jakubprzybytek/Environmental-Sensors/STM32CubeIDE/EnvSensorV2/ReadMe.md

## ToDo

### Software
* Logging data to SD card
* Displaying data from SD card using graphs
* Display
    - use it/dma mode to talk with display
* Get rid of synchronisation over I2C
    - Fix synchronisation issue
* Particles sensor
    - fix issue with auto start failure
    - stopAutoSend really needed?
    - calibration?

### Hardware
* Fix dc converters squeak
* Enable super capacitor as battery supply for RTC
* Run RTC on cristal
