jakubprzybytek/Environmental-Sensors/STM32CubeIDE/EnvSensorV2.1/TouchGFX/assets/images/low-batt-250.png

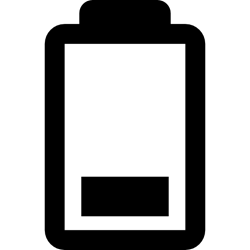
STM32CubeIDE/EnvSensorV2.1/TouchGFX/assets/images/low-batt-250.png
