jakubprzybytek/Environmental-Sensors/3dPrints/SFSD-05-28-H-05.00-SR.stp

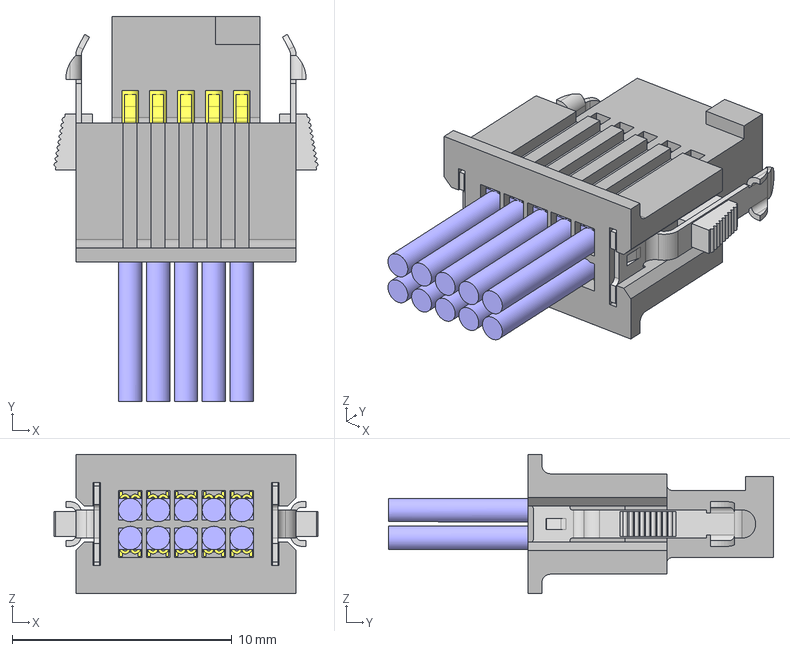
[picture p2: CAD file, 2024-03-20]
3dPrints/SFSD-05-28-H-05.00-SR.stp
12.0 x 17.5 x 6.35 mm
SFSD-05-28-SR_b
SFSD-05-28-D-NUS_ca
SFSX-RL x 2
SFSD-05_p x 2
