jakubprzybytek/Environmental-Sensors/KiCad/EnvSensor-Main-v2.1/Body1.stl

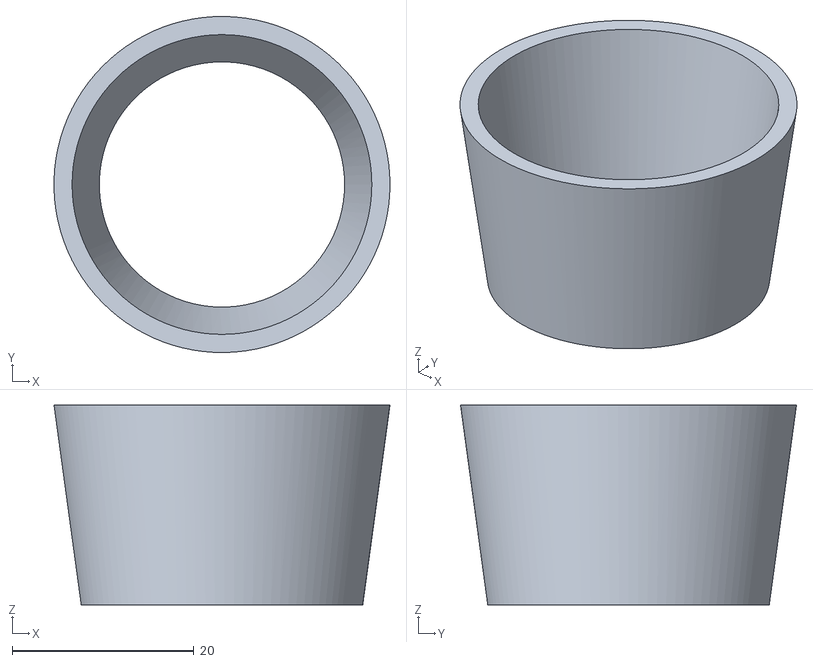
[picture p3: CAD file, 2024-09-21]
KiCad/EnvSensor-Main-v2.1/Body1.stl
37.0 x 37.0 x 22.0
