jakubprzybytek/Environmental-Sensors/3dPrints/Buttons Membrane v1.stl

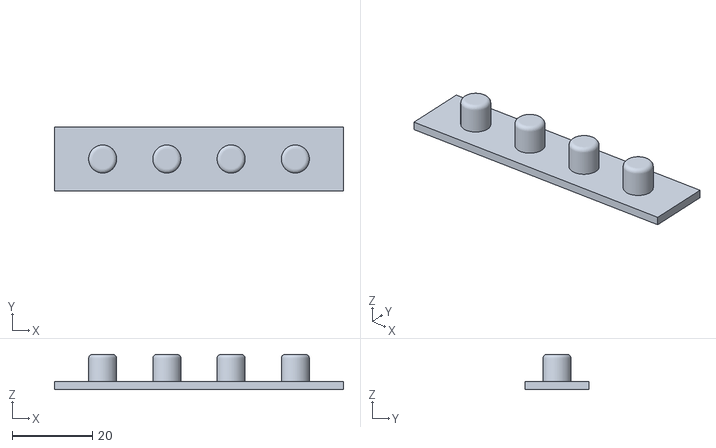
[picture p4: CAD file, 2021-03-12]
3dPrints/Buttons Membrane v1.stl
72.0 x 16.0 x 8.80
