jakubprzybytek/Environmental-Sensors/3dPrints/Case Bottom v2.stl

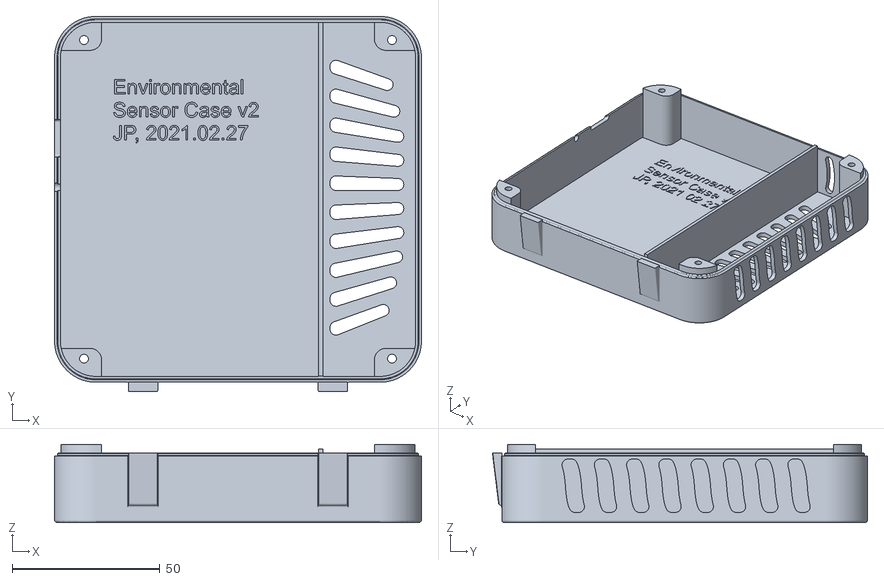
[picture p5: CAD file, 2021-03-12]
3dPrints/Case Bottom v2.stl
124.4 x 127.2 x 26.6
