jakubprzybytek/Environmental-Sensors/3dPrints/Case Top v2.stl

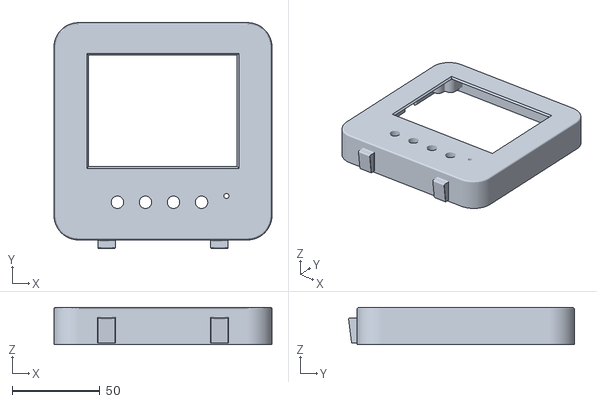
[picture p6: CAD file, 2021-03-12]
3dPrints/Case Top v2.stl
124.4 x 128.8 x 21.2
