jakubprzybytek/Environmental-Sensors/(list of files, cad)

Other CAD files:
3dPrints/Environmental Sensor Case v6.f3d
