jakubprzybytek/Environmental-Sensors/KiCad/EnvSensor-Power-v2.1/EnvSensor-Power-v2.1.kicad_pcb

## KiCad design KiCad/EnvSensor-Power-v2.1/EnvSensor-Power-v2.1.kicad_pcb (2024-12-12)

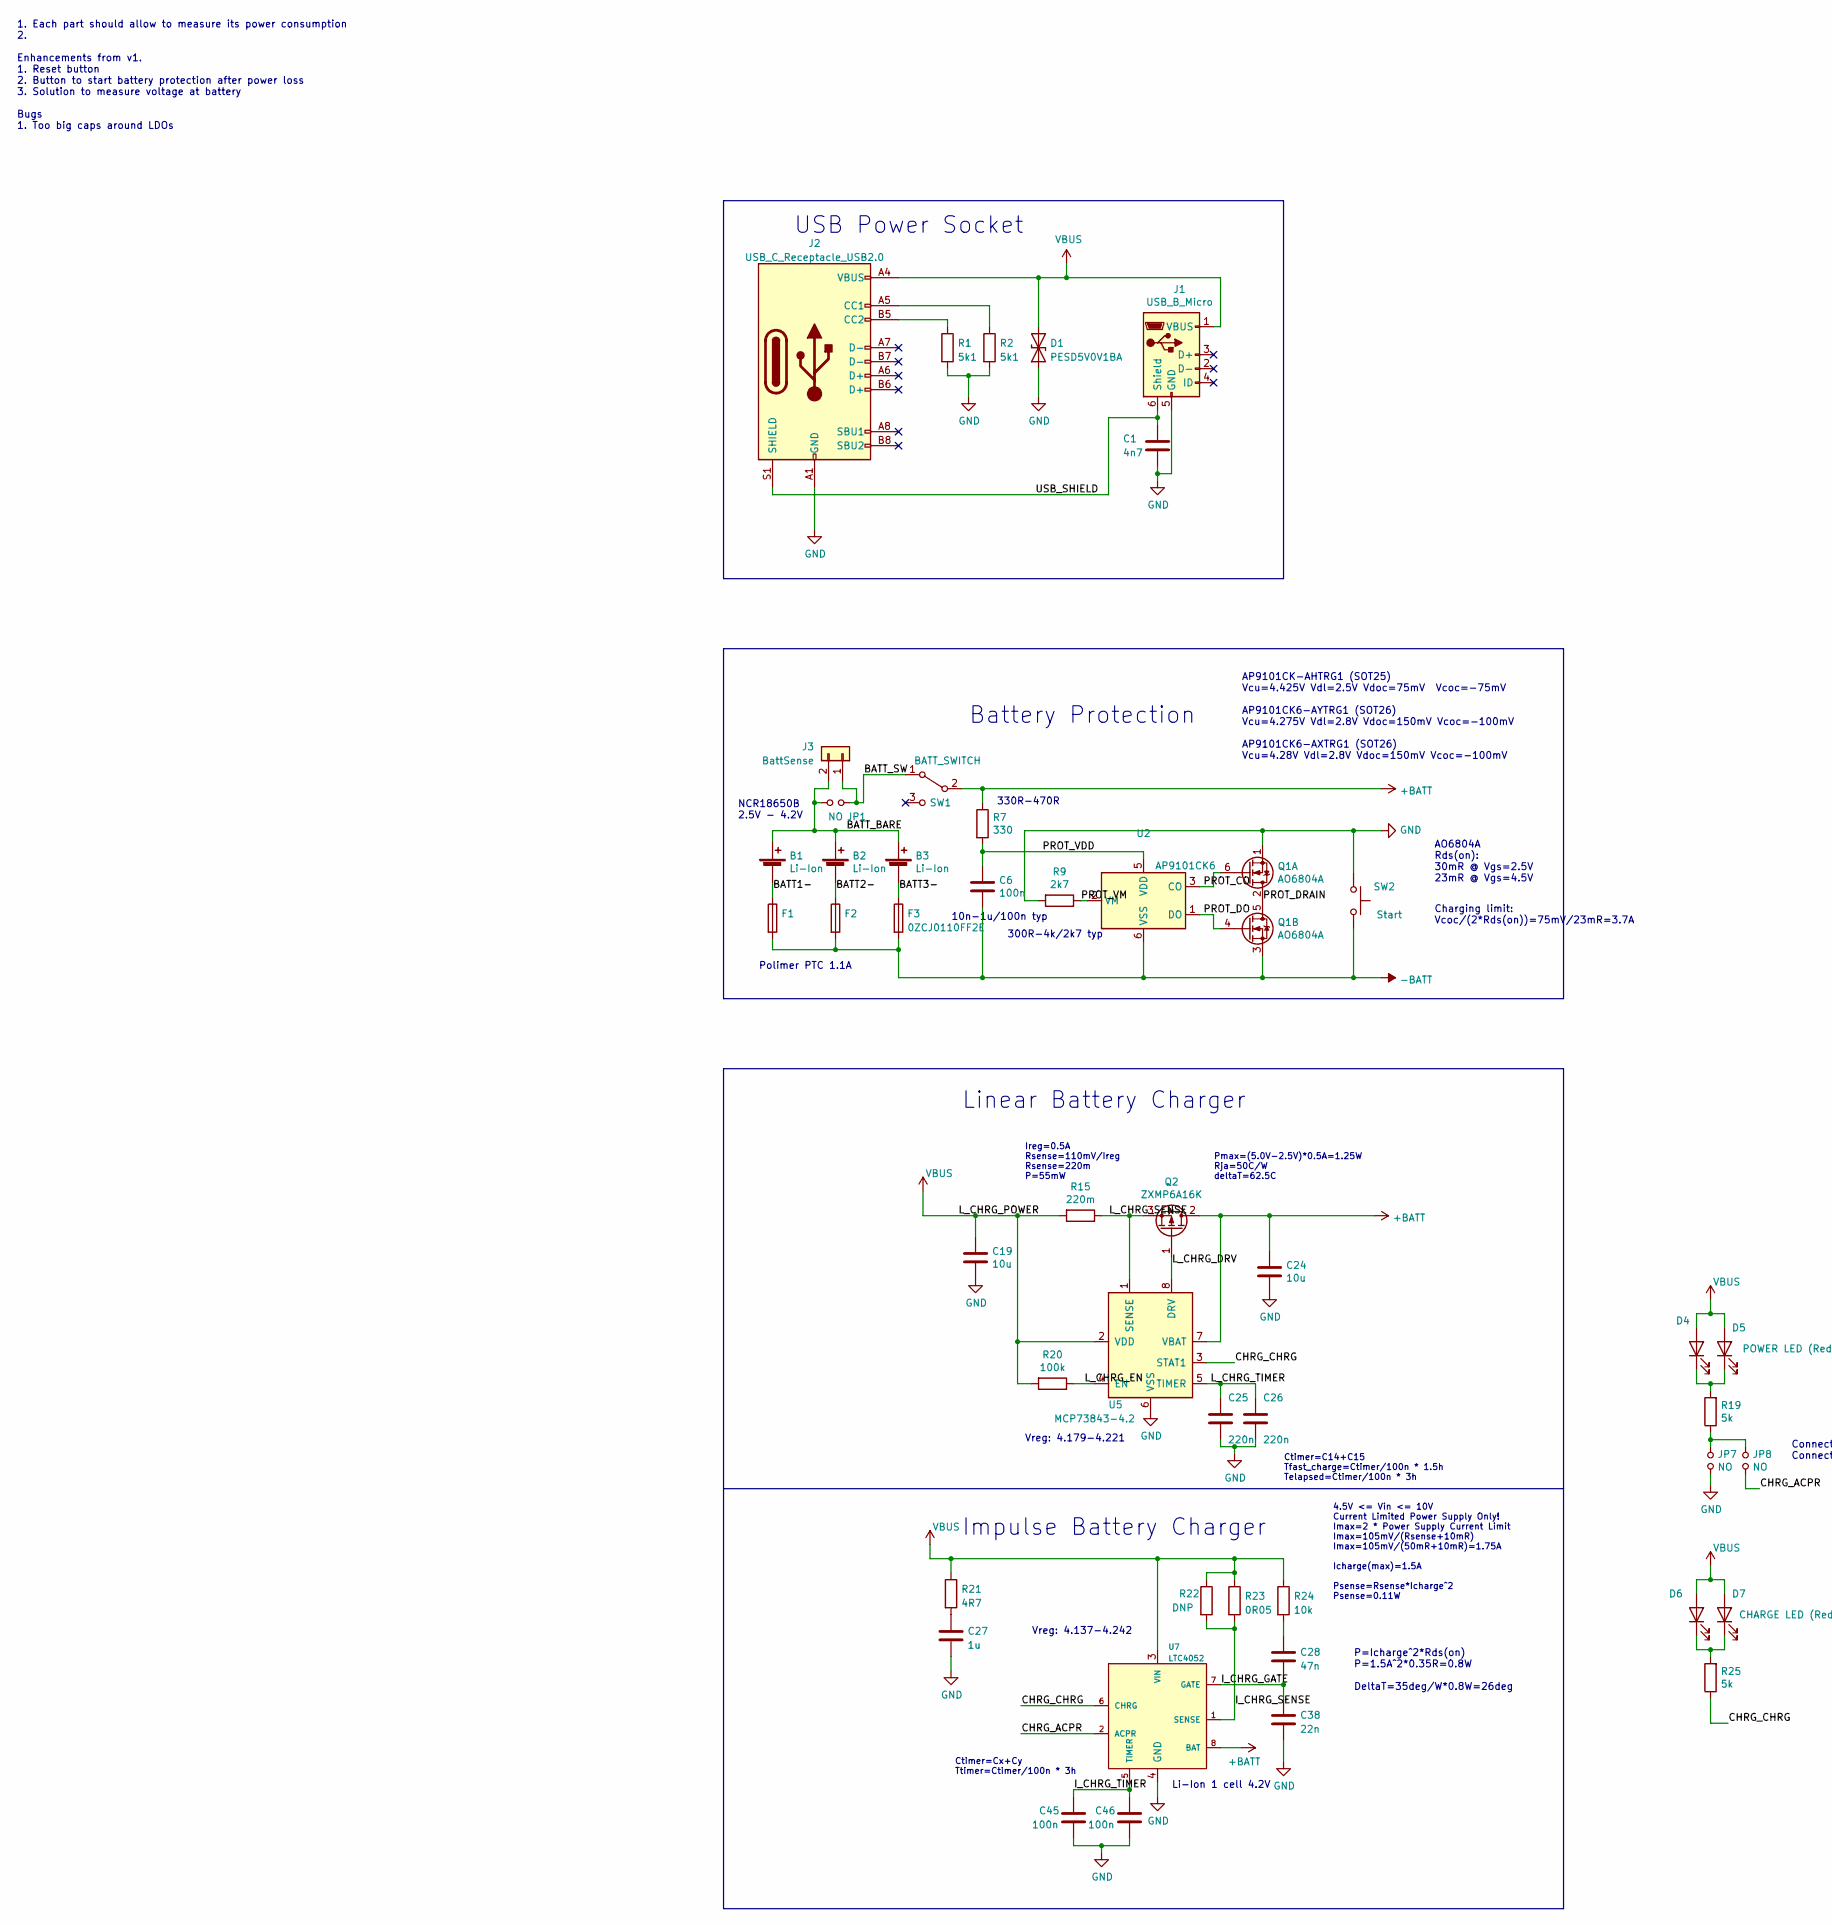
[picture p7: schematic EnvSensor-Power-v2.1.kicad_sch, Environmental Sensor Power Supply, part in row 1, column 1]

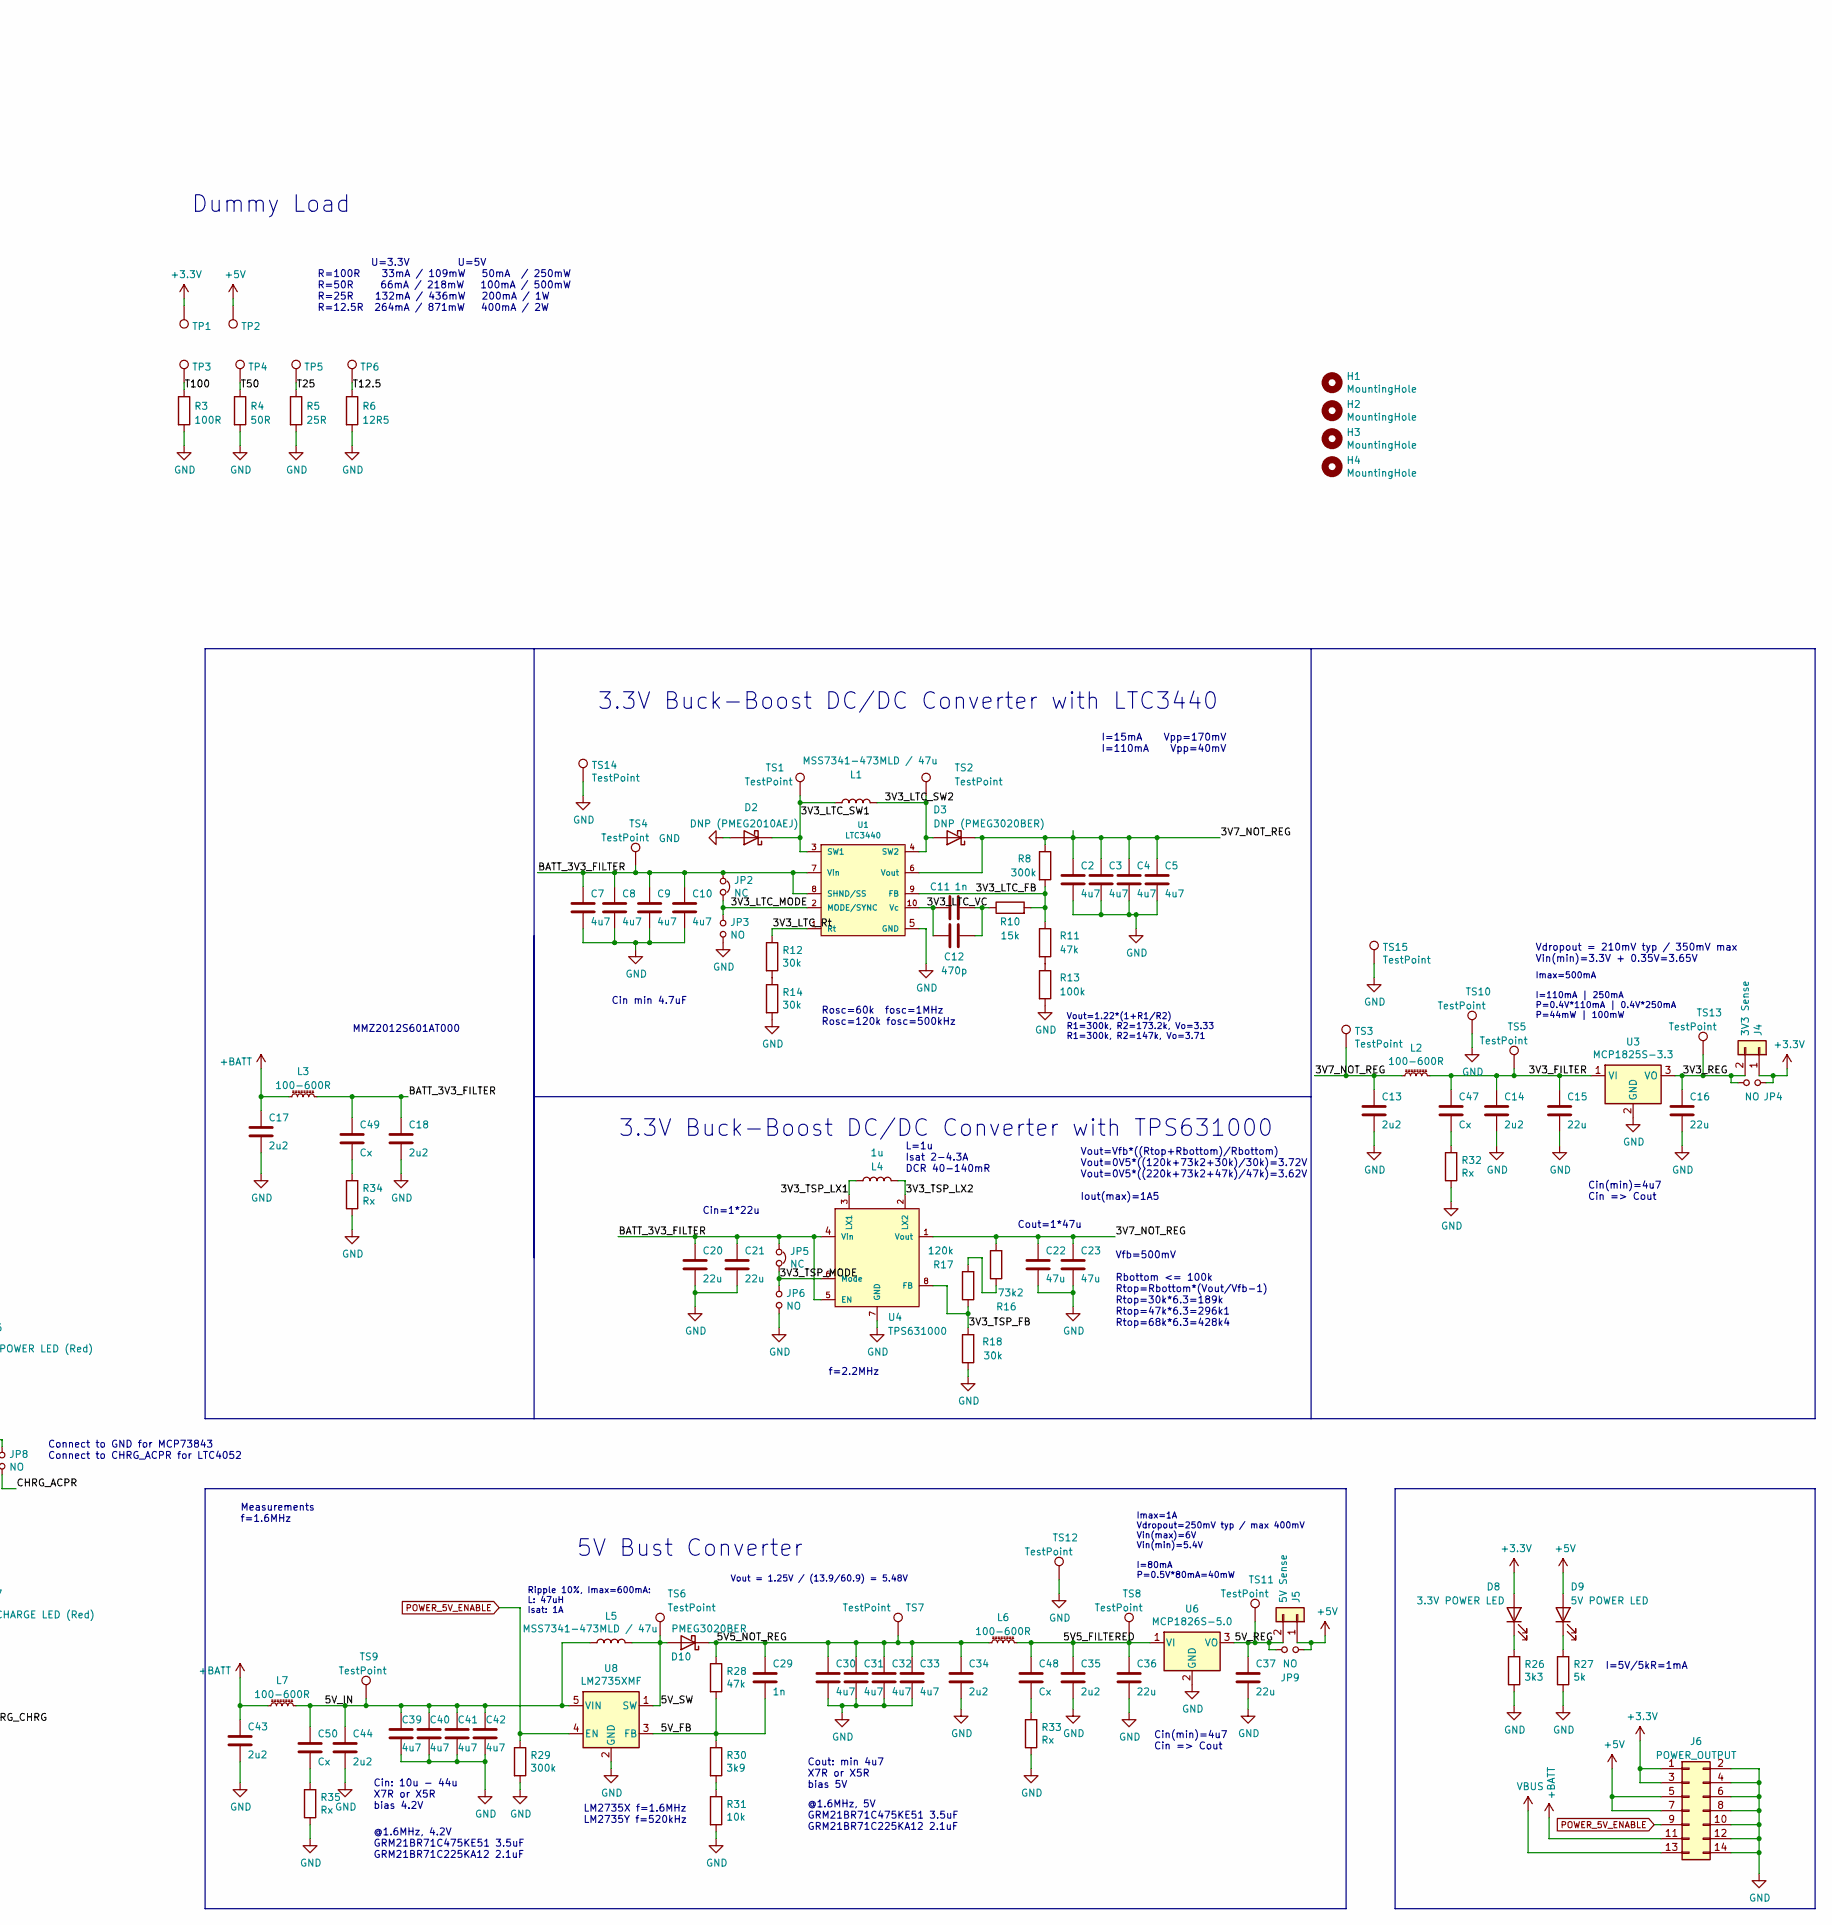
[picture p8: schematic EnvSensor-Power-v2.1.kicad_sch, Environmental Sensor Power Supply, part in row 1, column 2]

Parts:
B1, B2, B3: Li-Ion; BatteryHolder_Keystone_1042_1x18650
C1: 4n7; C_0805_2012Metric
C2, C3, C4, C5, C7, C8, C9, C10, C30, C31, C32, C33, C39, C40, C41, C42: 4u7; C_0805_2012Metric
C6, C45, C46: 100n; C_0603_1608Metric
C11, C29: 1n; C_0805_2012Metric
C12: 470p; C_0805_2012Metric
C13, C14, C17, C18, C34, C35, C43, C44: 2u2; C_0805_2012Metric
C15, C16, C20, C21, C36, C37: 22u; C_1206_3216Metric
C19, C24: 10u; C_0805_2012Metric
C22, C23: 47u; C_1206_3216Metric
C25, C26: 220n; C_0805_2012Metric
C27: 1u; C_0805_2012Metric
C28: 47n; C_0805_2012Metric
C38: 22n; C_0805_2012Metric
C47, C48, C49, C50: Cx; C_0805_2012Metric
D1: PESD5V0V1BA; D_SOD-323_HandSoldering
D2: DNP (PMEG2010AEJ); D_SOD-323_HandSoldering
D3: DNP (PMEG3020BER); D_SOD-123
D4: POWER LED (Red); LED_0805_2012Metric
D5: POWER LED (Red); LED_D3.0mm_Horizontal_O3.81mm_Z6.0mm
D6: CHARGE LED (Red); LED_0805_2012Metric
D7: CHARGE LED (Red); LED_D3.0mm_Horizontal_O3.81mm_Z6.0mm
D8: 3.3V POWER LED; LED_0805_2012Metric
D9: 5V POWER LED; LED_0805_2012Metric
D10: PMEG3020BER; D_SOD-123
F1, F2, F3: 0ZCJ0110FF2E; Fuse_1206_3216Metric
H1, H2, H3, H4: MountingHole; MountingHole_3.2mm_M3
J1: USB_B_Micro; USB_Micro-B_Molex_47346-0001
J2: USB_C_Receptacle_USB2.0; USB_C_Receptacle_GCT_USB4135-GF-A_6P_TopMnt_Horizontal
J3: BattSense; PinHeader_1x02_P2.54mm_Horizontal
J4: 3V3 Sense; PinHeader_1x02_P2.54mm_Horizontal
J5: 5V Sense; PinHeader_1x02_P2.54mm_Horizontal
J6: POWER_OUTPUT; PinHeader_2x07_P2.54mm_Vertical
JP1, JP3, JP4, JP6, JP7, JP8, JP9: NO; SolderJumper-2_P1.3mm_Open_RoundedPad1.0x1.5mm
JP2, JP5: NC; SolderJumper-2_P1.3mm_Bridged_RoundedPad1.0x1.5mm
L1, L5: MSS7341-473MLD / 47u; L_Bourns-SRN8040_8x8.15mm
L2, L3, L6, L7: 100-600R; L_0805_2012Metric
L4: 1u; L_0805_2012Metric
Q1: AO6804A; TSOT-23-6
Q2: ZXMP6A16K; TO-252-2
R1, R2: 5k1; R_0805_2012Metric
R3: 100R; R_2512_6332Metric
R4: 50R; R_2512_6332Metric
R5: 25R; R_2512_6332Metric
R6: 12R5; R_2512_6332Metric
R7: 330; R_0805_2012Metric
R8, R29: 300k; R_0805_2012Metric
R9: 2k7; R_0805_2012Metric
R10: 15k; R_0805_2012Metric
R11, R28: 47k; R_0805_2012Metric
R12, R14, R18: 30k; R_0805_2012Metric
R13: 100k; R_0805_2012Metric
R15: 220m; R_1206_3216Metric
R16: 73k2; R_0805_2012Metric
R17: 120k; R_0805_2012Metric
R19, R25, R27: 5k; R_0805_2012Metric
R20: 100k; R_0603_1608Metric
R21: 4R7; R_0805_2012Metric
R22: DNP; R_1206_3216Metric
R23: 0R05; R_1206_3216Metric
R24: 10k; R_0603_1608Metric
R26: 3k3; R_0805_2012Metric
R30: 3k9; R_0805_2012Metric
R31: 10k; R_0805_2012Metric
R32, R33, R34, R35: Rx; R_0805_2012Metric
SW1: BATT_SWITCH; SW_Lever_1P2T_NKK_GW12LxH
SW2: Start; SW_SPST_CK_RS282G05A3
TP1, TP2, TP3, TP4, TP5, TP6: TestPoint; TestPoint_THTPad_D1.5mm_Drill0.7mm
TS1, TS2, TS3, TS4, TS5, TS6, TS7, TS8, TS9, TS10, TS11, TS12, TS13, TS14, TS15: TestPoint; TestPoint_THTPad_D1.5mm_Drill0.7mm
U1: LTC3440; MSOP-10_3x3mm_P0.5mm
U2: AP9101CK6; SOT-23-6
U3: MCP1825S-3.3; SOT-223-3_TabPin2
U4: TPS631000; SOT-5x3
U5: MCP73843-4.2; MSOP-8_3x3mm_P0.65mm
U6: MCP1826S-5.0; SOT-223-3_TabPin2
U7: LTC4052; MSOP-8_3x3mm_P0.65mm
U8: LM2735XMF; SOT-23-5

Connections:
+3V3: D8.2 (A), J4.1, J6.1, J6.3, JP4.2, TP1.1
+5V: D9.2 (A), J5.1, J6.5, J6.7, JP9.2, TP2.1
+BATT: C17.1, C24.1, C43.1, J6.11, L3.1, L7.1, Q2.2 (D), R7.1, SW1.2 (B), U5.7 (VBAT), U7.8 (BAT)
-BATT: C6.2, F1.2, F2.2, F3.2, Q1.3 (S2), SW2.1, U2.6 (VSS)
/3V3_FILTER: C14.1, C15.1, C47.1, L2.2, TS5.1, U3.1 (VI)
/3V3_LTC_FB: R8.2, R10.2, R11.1, U1.9 (FB)
/3V3_LTC_MODE: JP2.2, JP3.1, U1.2 (MODE/SYNC)
/3V3_LTC_Rt: R12.1, U1.1 (Rt)
/3V3_LTC_SW1: D2.1 (K), L1.1, TS1.1, U1.3 (SW1)
/3V3_LTC_SW2: D3.2 (A), L1.2, TS2.1, U1.4 (SW2)
/3V3_LTC_VC: C11.2, C12.2, U1.10 (Vc)
/3V3_REG: C16.1, J4.2, JP4.1, TS13.1, U3.3 (VO)
/3V3_TSP_FB: R17.1, R18.2, U4.8 (FB)
/3V3_TSP_LX1: L4.1, U4.3 (LX1)
/3V3_TSP_LX2: L4.2, U4.2 (LX2)
/3V3_TSP_MODE: JP5.2, JP6.1, U4.6 (Mode)
/3V7_NOT_REG: C2.1, C3.1, C4.1, C5.1, C13.1, C22.1, C23.1, D3.1 (K), L2.1, R8.1, R16.2, TS3.1, U1.6 (Vout), U4.1 (Vout)
/5V5_FILTERED: C35.1, C36.1, C48.1, L6.2, TS8.1, U6.1 (VI)
/5V5_NOT_REG: C29.1, C30.1, C31.1, C32.1, C33.1, C34.1, D10.1 (K), L6.1, R28.1, TS7.1
/5V_FB: C29.2, R28.2, R30.1, U8.3 (FB)
/5V_IN: C39.1, C40.1, C41.1, C42.1, C44.1, C50.1, L5.1, L7.2, TS9.1, U8.5 (VIN); also elsewhere on the board
/5V_REG: C37.1, J5.2, JP9.1, TS11.1, U6.3 (VO)
/5V_SW: D10.2 (A), L5.2, TS6.1, U8.1 (SW)
/BATT1-: B1.2 (-), F1.1
/BATT2-: B2.2 (-), F2.1
/BATT3-: B3.2 (-), F3.1
/BATT_3V3_FILTER: C7.1, C8.1, C9.1, C10.1, C18.1, C20.1, C21.1, C49.1, JP2.1, JP5.1, L3.2, TS4.1, U1.7 (Vin), U1.8 (SHND/SS), U4.4 (Vin), U4.5 (EN)
/BATT_BARE: B1.1 (+), B2.1 (+), B3.1 (+), J3.2, JP1.1
/BATT_SW: J3.1, JP1.2, SW1.1 (A)
/CHRG_ACPR: JP8.2, U7.2 (ACPR)
/CHRG_CHRG: R25.1, U5.3 (STAT1), U7.6 (CHRG)
/I_CHRG_GATE: C28.2, C38.1, U7.7 (GATE)
/I_CHRG_SENSE: R22.2, R23.2, U7.1 (SENSE)
/I_CHRG_TIMER: C45.1, C46.1, U7.5 (TIMER)
/L_CHRG_DRV: Q2.1 (G), U5.8 (DRV)
/L_CHRG_EN: R20.1, U5.4 (EN)
/L_CHRG_SENSE: Q2.3 (S), R15.1, U5.1 (SENSE)
/L_CHRG_TIMER: C25.1, C26.1, U5.5 (TIMER)
/PROT_CO: Q1.6 (G2), U2.3 (CO)
/PROT_DO: Q1.4 (G2), U2.1 (DO)
/PROT_DRAIN: Q1.2 (D2), Q1.5 (D2)
/PROT_VDD: C6.1, R7.2, U2.5 (VDD)
/PROT_VM: R9.1, U2.2 (VM)
/T12.5: R6.1, TP6.1
/T25: R5.1, TP5.1
/T50: R4.1, TP4.1
/T100: R3.1, TP3.1
/USB_SHIELD: C1.1, J1.6 (Shield), J2.S1 (SHIELD)
GND: C1.2, C2.2, C3.2, C4.2, C5.2, C7.2, C8.2, C9.2, C10.2, C13.2, C14.2, C15.2, C16.2, C17.2, C18.2, C19.2, C20.2, C21.2, C22.2, C23.2, C24.2, C25.2, C26.2, C27.2, C30.2, C31.2, C32.2, C33.2, C34.2, C35.2, C36.2, C37.2, C38.2, C39.2, C40.2, C41.2, C42.2, C43.2, C44.2, C45.2, C46.2, D1.1 (A1), D2.2 (A), J1.5 (GND), J2.A1 (GND), J2.A12 (GND), J2.B1 (GND), J2.B12 (GND), J6.2, J6.4, J6.6, J6.8, J6.10, J6.12, J6.14, JP3.2, JP6.2, JP7.2, Q1.1 (S2), R1.2, R2.2, R3.2, R4.2, R5.2, R6.2, R9.2, R13.2, R14.2, R18.1, R26.1, R27.1, R29.2, R31.2, R32.1, R33.1, R34.1, R35.1, SW2.2, TS10.1, TS12.1, TS14.1, TS15.1, U1.5 (GND), U3.2 (GND), U4.7 (GND), U5.6 (VSS), U6.2 (GND), U7.4 (GND), U8.2 (GND)
unnamed: C11.1, C12.1, R10.1
unnamed: C27.1, R21.2
unnamed: C28.1, R24.2
unnamed: C47.2, R32.2
unnamed: C48.2, R33.2
unnamed: C49.2, R34.2
unnamed: C50.2, R35.2
unnamed: D4.1 (K), D5.1 (K), R19.2
unnamed: D6.1 (K), D7.1 (K), R25.2
unnamed: D8.1 (K), R26.2
unnamed: D9.1 (K), R27.2
unnamed: J2.A5 (CC1), R2.1
unnamed: J2.B5 (CC2), R1.1
unnamed: JP7.1, JP8.1, R19.1
unnamed: R11.2, R13.1
unnamed: R12.2, R14.1
unnamed: R16.1, R17.2
unnamed: R30.2, R31.1
POWER_5V_ENABLE: J6.9, R29.1, U8.4 (EN)
VBUS: C19.1, D1.2 (A2), D4.2 (A), D5.2 (A), D6.2 (A), D7.2 (A), J1.1 (VBUS), J2.A4 (VBUS), J2.A9 (VBUS), J2.B4 (VBUS), J2.B9 (VBUS), J6.13, R15.2, R20.2, R21.1, R22.1, R23.1, R24.1, U5.2 (VDD), U7.3 (VIN)

Notes on the sheet:
Ripple 10%, Imax=600mA: L: 47uH Isat: 1A
AP9101CK-AHTRG1 (SOT25) Vcu=4.425V Vdl=2.5V Vdoc=75mV Vcoc=-75mV AP9101CK6-AYTRG1 (SOT26) Vcu=4.275V Vdl=2.8V Vdoc=150mV Vcoc=-100mV AP9101CK6-AXTRG1 (SOT26) Vcu=4.28V Vdl=2.8V Vdoc=150mV Vcoc=-100mV
Cout: min 4u7 X7R or X5R bias 5V
1. Each part should allow to measure its power consumption 2. Enhancements from v1. 1. Reset button 2. Button to start battery protection after power loss 3. Solution to measure voltage at battery Bugs 1. Too big caps around LDOs
Linear Battery Charger
Connect to GND for MCP73843 Connect to CHRG_ACPR for LTC4052
330R-470R
5V Bust Converter
Ireg=0.5A Rsense=110mV/Ireg Rsense=220m P=55mW
MMZ2012S601AT000
Pmax=(5.0V-2.5V)*0.5A=1.25W Rja=50C/W deltaT=62.5C
Ctimer=Cx+Cy Ttimer=Ctimer/100n * 3h
Vfb=500mV Rbottom <= 100k Rtop=Rbottom*(Vout/Vfb-1) Rtop=30k*6.3=189k Rtop=47k*6.3=296k1 Rtop=68k*6.3=428k4
I=15mA Vpp=170mV I=110mA Vpp=40mV
Li-Ion 1 cell 4.2V
3.3V Buck-Boost DC/DC Converter with LTC3440
Impulse Battery Charger
Cin(min)=4u7 Cin => Cout
Cin min 4.7uF
Imax=500mA I=110mA | 250mA P=0.4V*110mA | 0.4V*250mA P=44mW | 100mW
I=5V/5kR=1mA
Cout=1*47u
@1.6MHz, 4.2V GRM21BR71C475KE51 3.5uF GRM21BR71C225KA12 2.1uF
AO6804A Rds(on): 30mR @ Vgs=2.5V 23mR @ Vgs=4.5V
USB Power Socket
4.5V <= Vin <= 10V Current Limited Power Supply Only! Imax=2 * Power Supply Current Limit Imax=105mV/(Rsense+10mR) Imax=105mV/(50mR+10mR)=1.75A Icharge(max)=1.5A Psense=Rsense*Icharge^2 Psense=0.11W
Rosc=60k fosc=1MHz Rosc=120k fosc=500kHz
Cin=1*22u
Ctimer=C14+C15 Tfast_charge=Ctimer/100n * 1.5h Telapsed=Ctimer/100n * 3h
Dummy Load
L=1u Isat 2-4.3A DCR 40-140mR
3.3V Buck-Boost DC/DC Converter with TPS631000
f=2.2MHz
Vreg: 4.179-4.221
Vdropout = 210mV typ / 350mV max Vin(min)=3.3V + 0.35V=3.65V
Cin: 10u - 44u X7R or X5R bias 4.2V
Vout=1.22*(1+R1/R2) R1=300k, R2=173.2k, Vo=3.33 R1=300k, R2=147k, Vo=3.71
P=Icharge^2*Rds(on) P=1.5A^2*0.35R=0.8W DeltaT=35deg/W*0.8W=26deg
U=3.3V U=5V R=100R 33mA / 109mW 50mA / 250mW R=50R 66mA / 218mW 100mA / 500mW R=25R 132mA / 436mW 200mA / 1W R=12.5R 264mA / 871mW 400mA / 2W
Imax=1A Vdropout=250mV typ / max 400mV Vin(max)=6V Vin(min)=5.4V I=80mA P=0.5V*80mA=40mW
300R-4k/2k7 typ
Vout=Vfb*((Rtop+Rbottom)/Rbottom) Vout=0V5*((120k+73k2+30k)/30k)=3.72V Vout=0V5*((220k+73k2+47k)/47k)=3.62V Iout(max)=1A5
Polimer PTC 1.1A
Charging limit: Vcoc/(2*Rds(on))=75mV/23mR=3.7A
@1.6MHz, 5V GRM21BR71C475KE51 3.5uF GRM21BR71C225KA12 2.1uF
LM2735X f=1.6MHz LM2735Y f=520kHz
Vout = 1.25V / (13.9/60.9) = 5.48V
Vreg: 4.137-4.242
NCR18650B 2.5V - 4.2V
Battery Protection
10n-1u/100n typ
Measurements f=1.6MHz

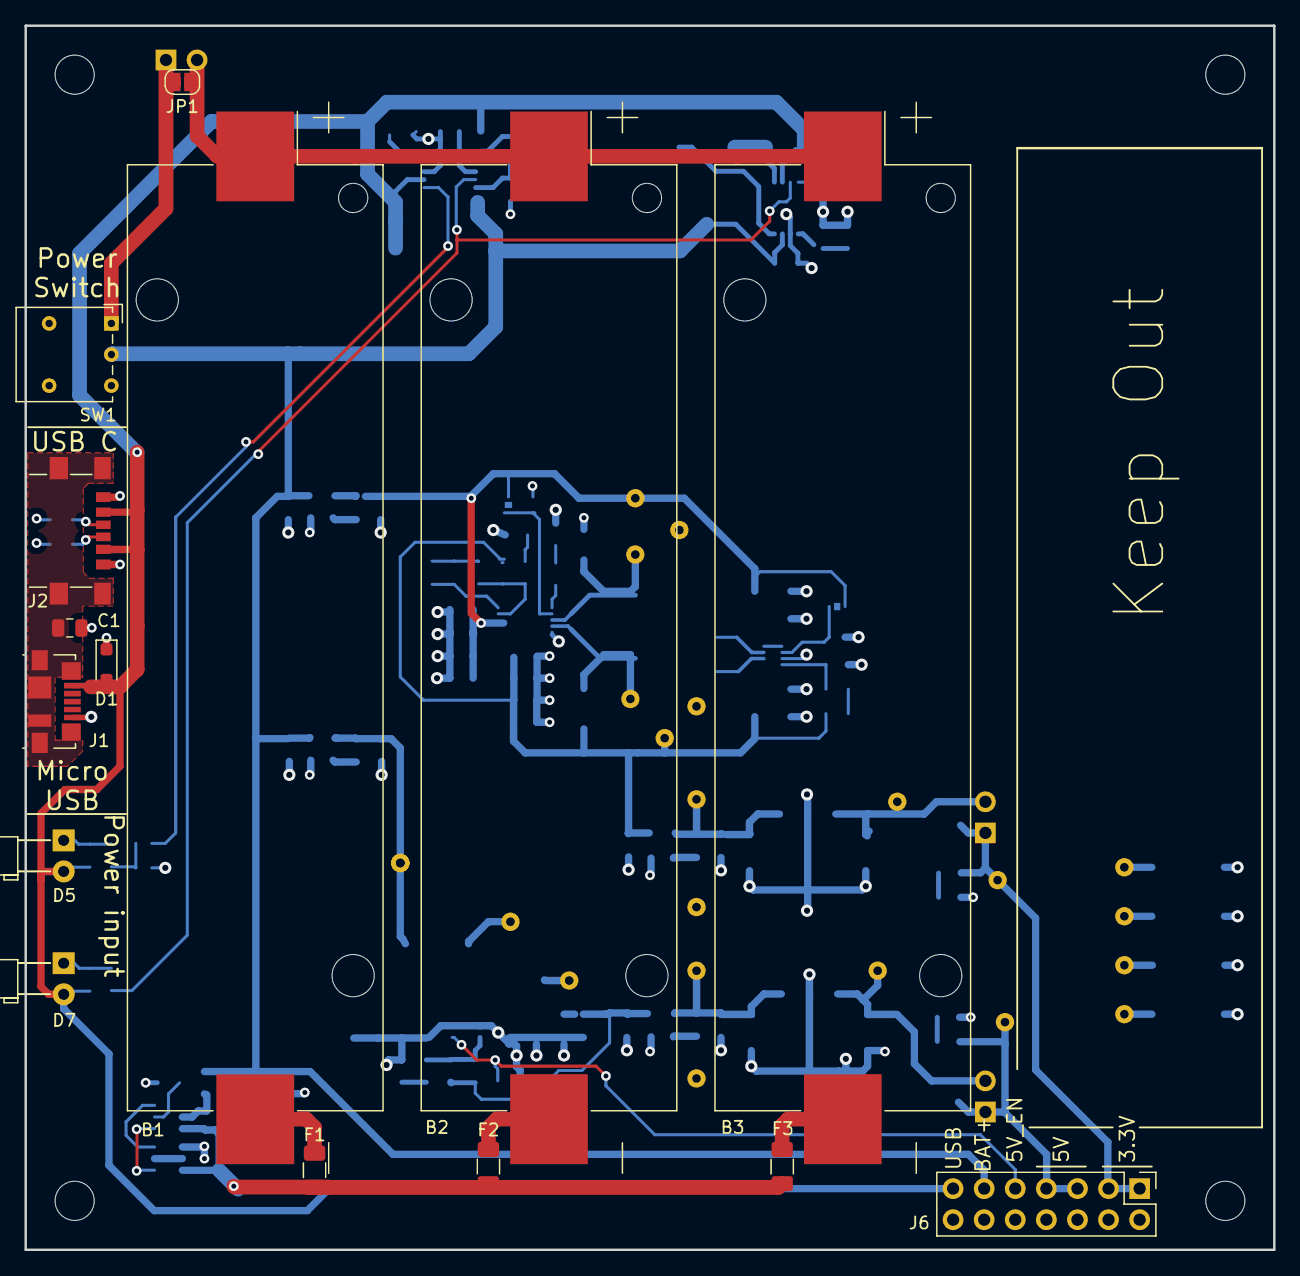
[picture p9: board EnvSensor-Power-v2.1.kicad_pcb from above]

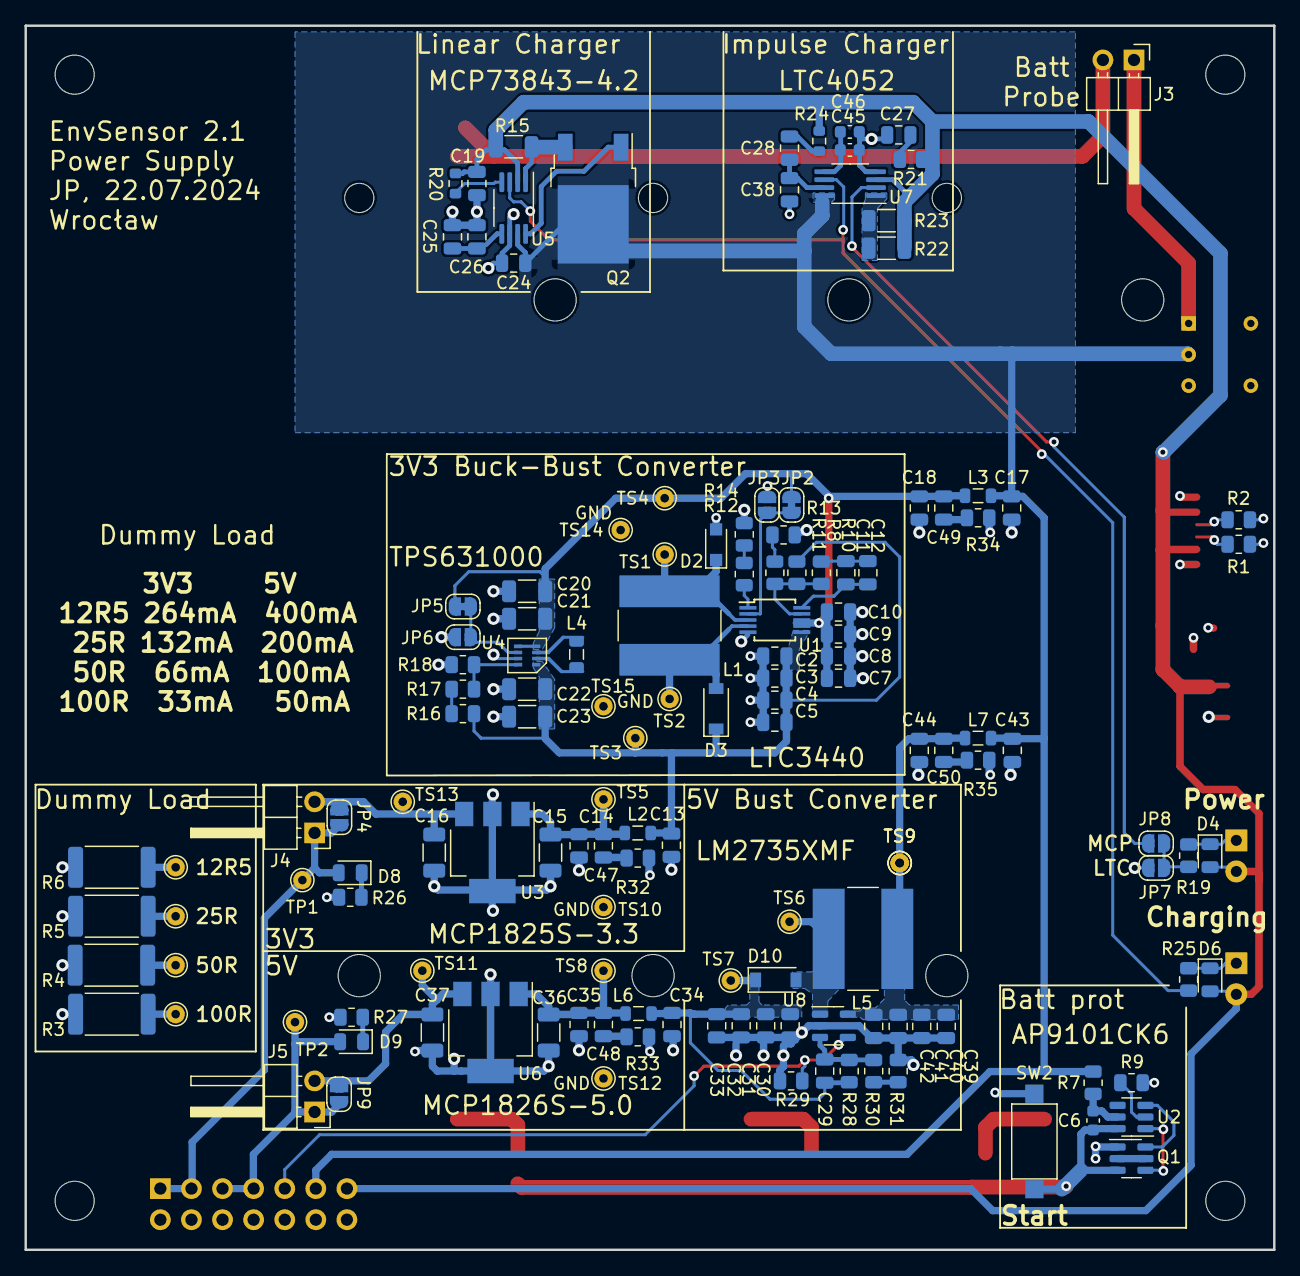
[picture p10: board EnvSensor-Power-v2.1.kicad_pcb from below]

Board: 4 copper layers, 102.0 x 100.0 mm, 161 parts (142 on the bottom side), 69 nets.

Other parts of the board:
TS9#2: TestPoint; TestPoint_THTPad_D1.5mm_Drill0.7mm

Their connections:
/5V_IN: TS9#2.1; also elsewhere on the board
