jakubprzybytek/Environmental-Sensors/KiCad/EnvSensor-Main-v2.1/EnvSensor-Main-v2.1.kicad_pcb

## KiCad design KiCad/EnvSensor-Main-v2.1/EnvSensor-Main-v2.1.kicad_pcb (2024-09-29)

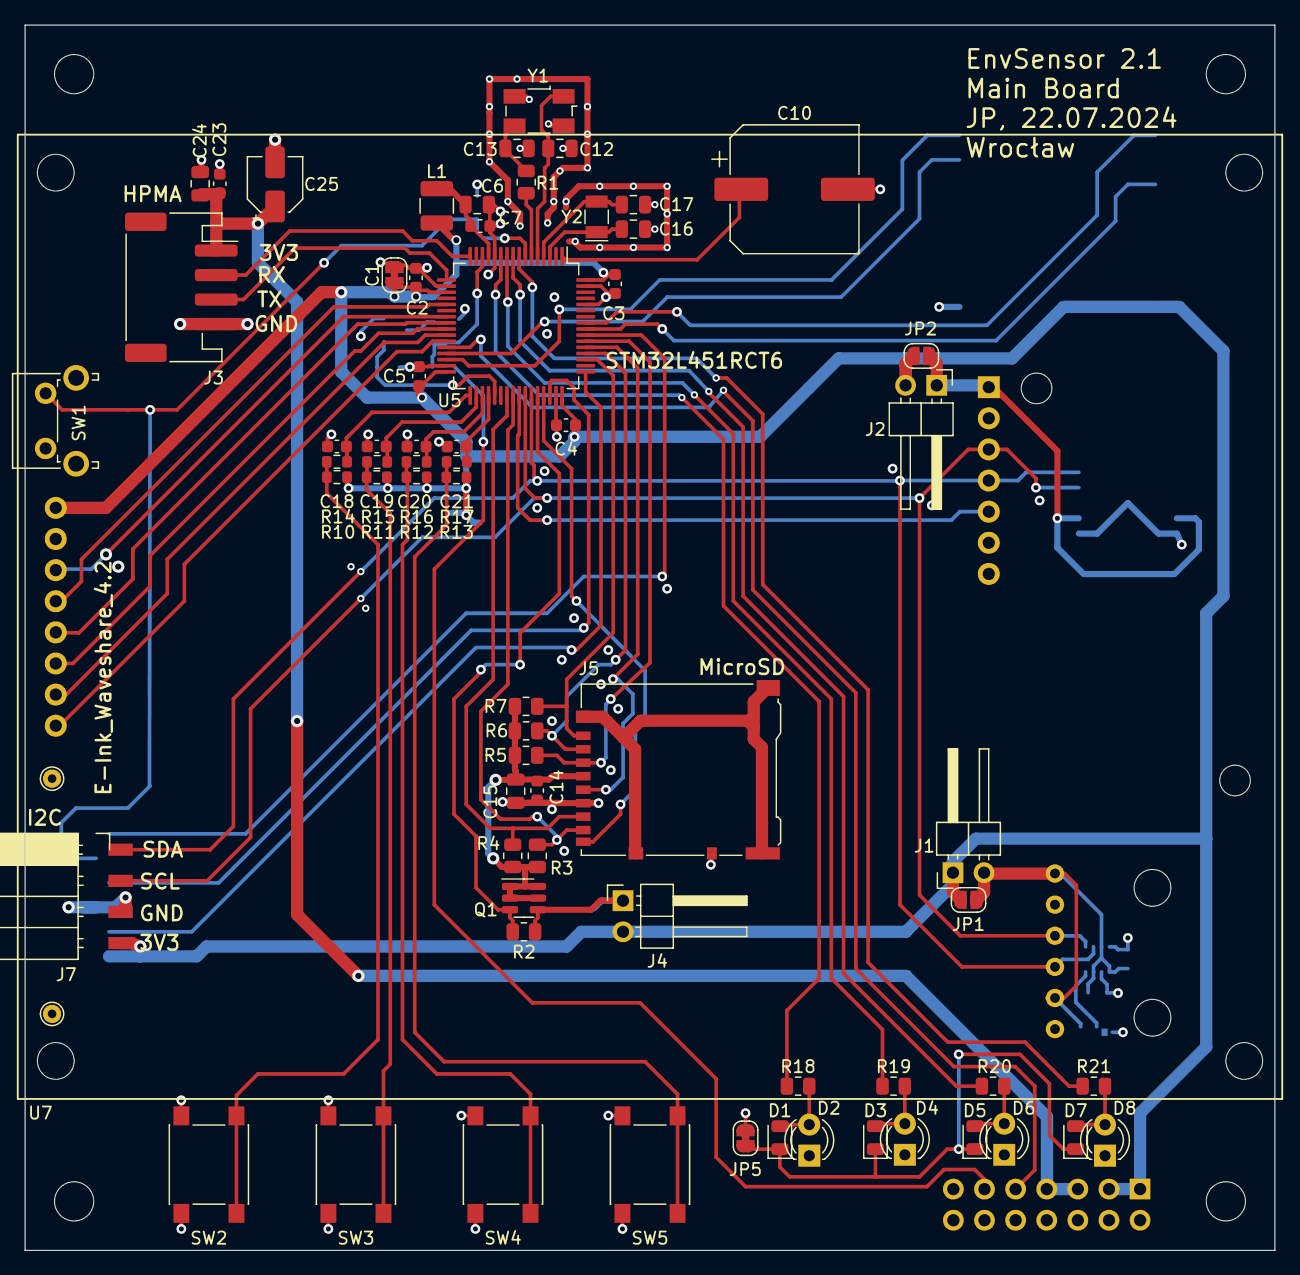
[picture p11: board EnvSensor-Main-v2.1.kicad_pcb from above]

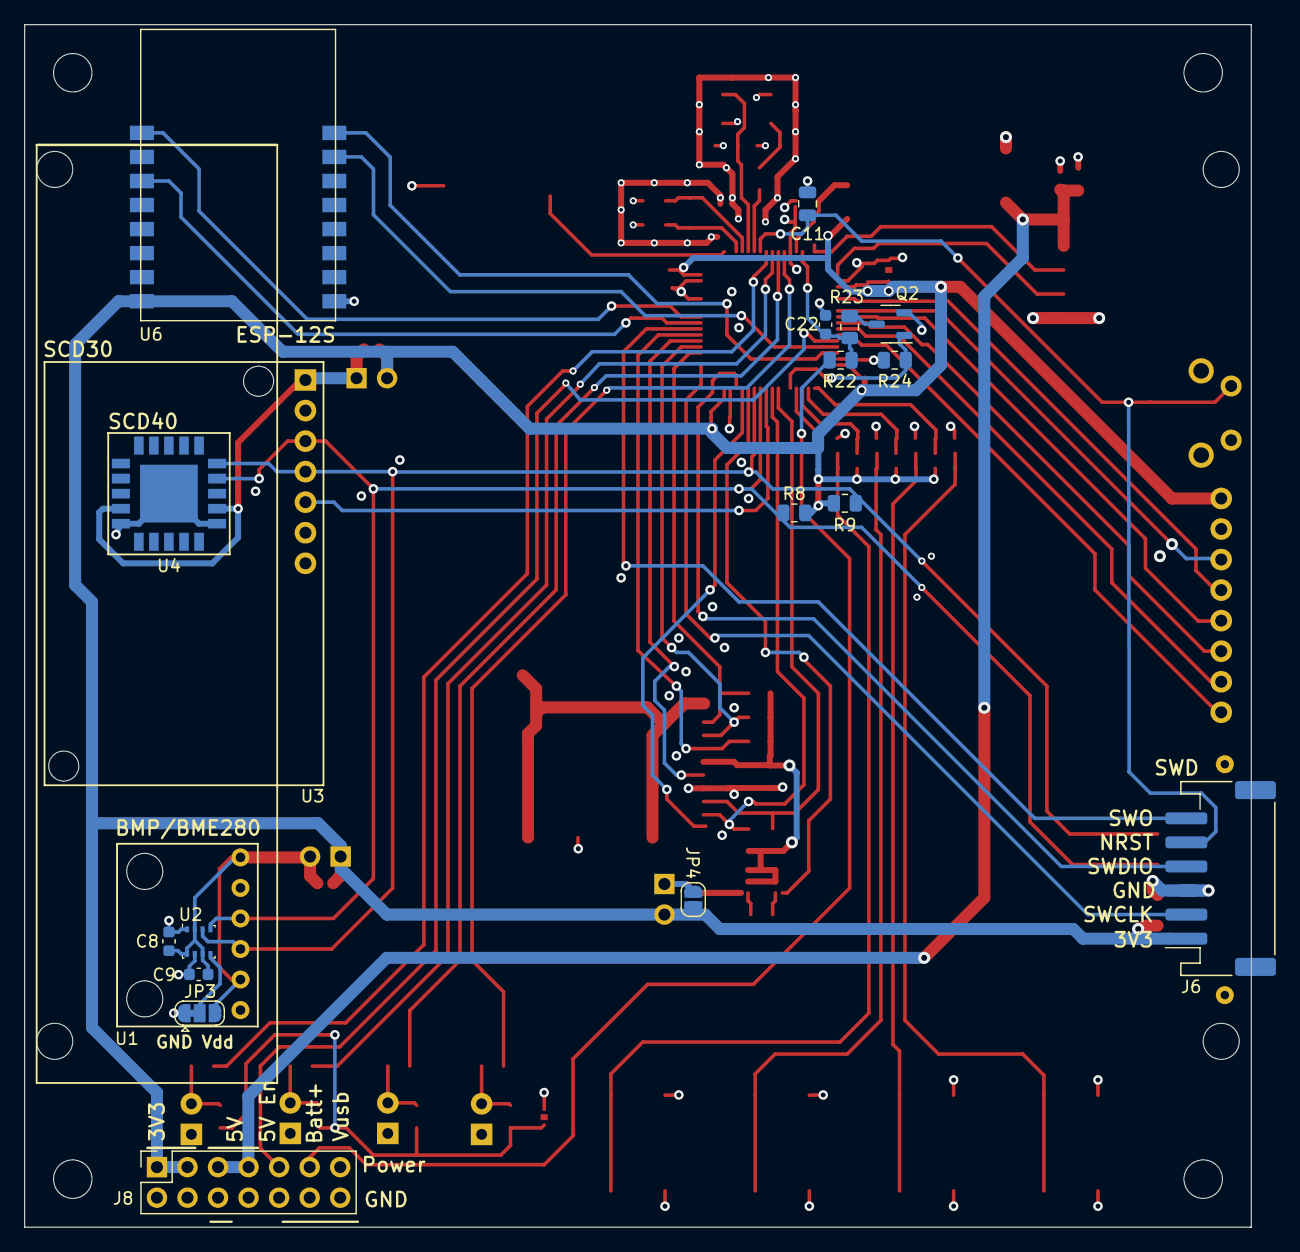
[picture p12: board EnvSensor-Main-v2.1.kicad_pcb from below]

Board: 4 copper layers, 102.0 x 100.0 mm, 93 parts (19 on the bottom side), 64 nets.

Parts:
C1: 10u; SolderJumper-2_P1.3mm_Bridged_RoundedPad1.0x1.5mm
C2, C3, C4, C5, C7, C8, C9, C14, C18, C19, C20, C21, C22, C23: 100n; C_0603_1608Metric
C6: 1u; C_0805_2012Metric
C10: SuperCap; CP_Elec_10x7.7
C11, C24: 10n; C_0805_2012Metric
C12, C13: 6p; C_0805_2012Metric
C15: 10u; C_0805_2012Metric
C16, C17: 15p; C_0805_2012Metric
C25: 22u; CP_Elec_4x5.3
D1: CPU_LED; LED_0805_2012Metric
D2, D4, D6, D8: LED; LED_D3.0mm
D3: SD_LED; LED_0805_2012Metric
D5, D7: LED; LED_0805_2012Metric
H1, H2, H3, H4: MountingHole; MountingHole_3.2mm_M3
H5, H6: MountingHole; TestPoint_THTPad_D1.5mm_Drill0.7mm
J1, J2, J4: Conn_01x02; PinHeader_1x02_P2.54mm_Horizontal
J3: HPMA115C0-003; JST_PH_S4B-PH-SM4-TB_1x04-1MP_P2.00mm_Horizontal
J5: Micro_SD_Card_Det; microSD_HC_Hirose_DM3AT-SF-PEJM5
J6: SWD; JST_PH_S6B-PH-SM4-TB_1x06-1MP_P2.00mm_Horizontal
J7: I2C; PinSocket_1x04_P2.54mm_Horizontal_SMD
J8: POWER_INPUT; PinSocket_2x07_P2.54mm_Vertical
JP1, JP2, JP4: NO; SolderJumper-2_P1.3mm_Open_RoundedPad1.0x1.5mm
JP3: Address; SolderJumper-3_P1.3mm_Bridged12_RoundedPad1.0x1.5mm
JP5: NC; SolderJumper-2_P1.3mm_Bridged_RoundedPad1.0x1.5mm
L1: 10u; L_1210_3225Metric
Q1: Si3407DV; TSOT-23-6
Q2: IRLML2502; SOT-23-3
R1, R18, R19, R20, R21: 2k2; R_0805_2012Metric
R2: 300k; R_0805_2012Metric
R3, R4, R5, R6, R7: 33k; R_0805_2012Metric
R8, R9, R23: 10k; R_0805_2012Metric
R10, R11, R12, R13, R14, R15, R16, R17: 10k; R_0603_1608Metric
R22: 3k; R_0805_2012Metric
R24: 100k; R_0805_2012Metric
SW1: Reset; SW_Tactile_SPST_Angled_PTS645Vx83-2LFS
SW2, SW3, SW4, SW5: SW_Push; SW_SPST_PTS645
U1: BME280-Module
U2: BMP280; Bosch_LGA-8_2.5x2.5mm_P0.65mm_ClockwisePinNumbering
U3: SCD30
U4: SCD40; SCD4x
U5: STM32L451RCT6; LQFP-64_10x10mm_P0.5mm
U6: ESP-12S
U7: E-Ink_Waveshare_4.2; 4.2inch_E-Ink
Y1: 16MHz; Crystal_SMD_Abracon_ABM3B-4Pin_5.0x3.2mm
Y2: 32768/12.5pF; Crystal_SMD_MicroCrystal_CC7V-T1A-2Pin_3.2x1.5mm

Connections:
+3.3VA: C6.1, C7.1, L1.2, U5.13 (VDDA)
+3V3: C1.1, C2.1, C3.1, C4.1, C5.1, J1.1, J2.2, J4.2, J6.1, J7.4, J8.1, J8.3, JP1.2, JP2.2, JP4.1, L1.1, R8.2, R9.2, R10.1, R11.1, R12.1, R13.1, U5.19 (VDD), U5.32 (VDD), U5.48 (VDDUSB), U5.64 (VDD), U6.8 (VCC), U7.1 (VDD)
+5V: C23.1, C24.1, C25.1, J3.1, J8.5, J8.7
+BATT: J8.11, R22.1
/BMP280_VCC: C8.1, C9.1, J1.2, JP1.1, JP3.3 (B), U1.1 (VDD), U1.5 (CSB), U2.2 (CSB), U2.6 (VDDIO), U2.8 (VDD)
/SCD_POWER: J2.1, JP2.1, U3.1 (VDD), U4.7 (VDD), U4.19 (VDDH)
/SD_3V3: C14.2, C15.2, J5.4 (VDD), Q1.1 (D), Q1.2 (D), Q1.5 (D), Q1.6 (D), R3.2, R4.2, R5.2, R6.2, R7.2
/VBAT: C10.1, U5.1 (VBAT)
BATTERY_MEASURE_ENABLE: Q2.1 (G), R24.1, U5.37 (PC6)
BATTERY_MEASURE_INPUT: C22.1, R22.2, R23.1, U5.14 (PA0)
E_INK_BUSY: U5.27 (PB1), U7.8 (BUSY)
E_INK_DC: U5.25 (PC5), U7.6 (DC)
E_INK_RESET: U5.26 (PB0), U7.7 (RST)
E_INK_SELECT: U5.24 (PC4), U7.5 (CS)
GND: C1.2, C2.2, C3.2, C4.2, C5.2, C6.2, C7.2, C8.2, C9.2, C10.2, C11.1, C12.2, C13.2, C14.1, C15.1, C16.2, C17.2, C18.2, C19.2, C20.2, C21.2, C22.2, C23.2, C24.2, C25.2, D2.1 (K), D4.1 (K), D6.1 (K), D8.1 (K), J3.4, J5.6 (VSS), J5.10 (DET_A), J6.3, J7.3, J8.2, J8.4, J8.6, J8.8, J8.10, J8.12, J8.14, JP3.1 (A), JP5.2 (B), Q2.2 (S), R24.2, SW1.1, SW2.1, SW3.1, SW4.1, SW5.1, U1.2 (GND), U1.6 (SDO), U2.1 (GND), U2.7 (GND), U3.2 (GND), U3.7 (SEL), U4.6 (GND), U4.20 (GND), U4.21 (GND), U5.12 (VSSA), U5.18 (VSS), U5.31 (VSS), U5.47 (VSS), U5.60 (PH3), U5.63 (VSS), U6.9 (GND), U7.2 (GND), Y1.2, Y1.4
HPMA_RX: J3.2, U5.16 (PA2)
HPMA_TX: J3.3, U5.17 (PA3)
LED_1: R18.1, U5.11 (PC3)
LED_2: R19.1, U5.10 (PC2)
LED_3: R20.1, U5.9 (PC1)
LED_4: R21.1, U5.8 (PC0)
MOSI: U5.23 (PA7), U7.3 (DIN)
NRST: C11.2, J6.5, SW1.2, U5.7 (NRST)
unnamed: C13.1, R1.2, Y1.3
unnamed: D1.2 (A), D2.2 (A), R18.2
unnamed: D1.1 (K), D3.1 (K), D5.1 (K), D7.1 (K), JP5.1 (A)
unnamed: D3.2 (A), D4.2 (A), R19.2
unnamed: D5.2 (A), D6.2 (A), R20.2
unnamed: D7.2 (A), D8.2 (A), R21.2
unnamed: J4.1, JP4.2, Q1.4 (S), R2.1
unnamed: JP3.2 (C), U2.5 (SDO)
unnamed: Q2.3 (D), R23.2
unnamed: R10.2, R14.2, SW2.2
unnamed: R11.2, R15.2, SW3.2
unnamed: R12.2, R16.2, SW4.2
unnamed: R13.2, R17.2, SW5.2
unnamed: C16.1, U5.3 (PC14), Y2.1
unnamed: C17.1, U5.4 (PC15), Y2.2
unnamed: C12.1, U5.5 (PH0), Y1.1
unnamed: R1.1, U5.6 (PH1)
POWER_5V_ENABLE: J8.9, U5.28 (PB2)
SCD30_READY: U3.5 (RDY), U5.41 (PA8)
SCK: U5.21 (PA5), U7.4 (CLK)
SCL: J7.2, R8.1, U1.3 (SCL), U2.4 (SCK), U3.3 (TX/SCL), U4.9 (SCL), U5.42 (PA9)
SDA: J7.1, R9.1, U1.4 (SDA), U2.3 (SDI), U3.4 (RX/SDA), U4.10 (SDA), U5.43 (PA10)
SDIO_CLK: J5.5 (CLK), U5.53 (PC12)
SDIO_CMD: J5.3 (CMD), R5.1, U5.54 (PD2)
SDIO_DATA0: J5.7 (DAT0), R4.1, U5.39 (PC8)
SDIO_DATA1: J5.8 (DAT1), R3.1, U5.40 (PC9)
SDIO_DATA2: J5.1 (DAT2), R7.1, U5.51 (PC10)
SDIO_DATA3: J5.2 (DAT3/CD), R6.1, U5.52 (PC11)
SDIO_DETECT: J5.9 (DET_B), U5.45 (PA12)
SDIO_POWER_ENABLE: Q1.3 (G), R2.2, U5.44 (PA11)
SWCLK: J6.2, U5.49 (PA14)
SWDIO: J6.4, U5.46 (PA13)
SWITCH_1: C18.1, R14.1, U5.33 (PB12)
SWITCH_2: C19.1, R15.1, U5.34 (PB13)
SWITCH_3: C20.1, R16.1, U5.35 (PB14)
SWITCH_4: C21.1, R17.1, U5.36 (PB15)
SWO: J6.6, U5.55 (PB3)
WFI_TX: U5.30 (PB11), U6.16 (TXD0)
WIFI_ENABLE: U5.56 (PB4), U6.3 (EN)
WIFI_RESET: U5.57 (PB5), U6.1 (Reset)
WIFI_RX: U5.29 (PB10), U6.15 (RXD0)
