jakubprzybytek/Environmental-Sensors/KiCad/EnvSensor-v2/EnvSensor-v2.kicad_pcb

## KiCad design KiCad/EnvSensor-v2/EnvSensor-v2.kicad_pcb (2023-04-29, an earlier design)

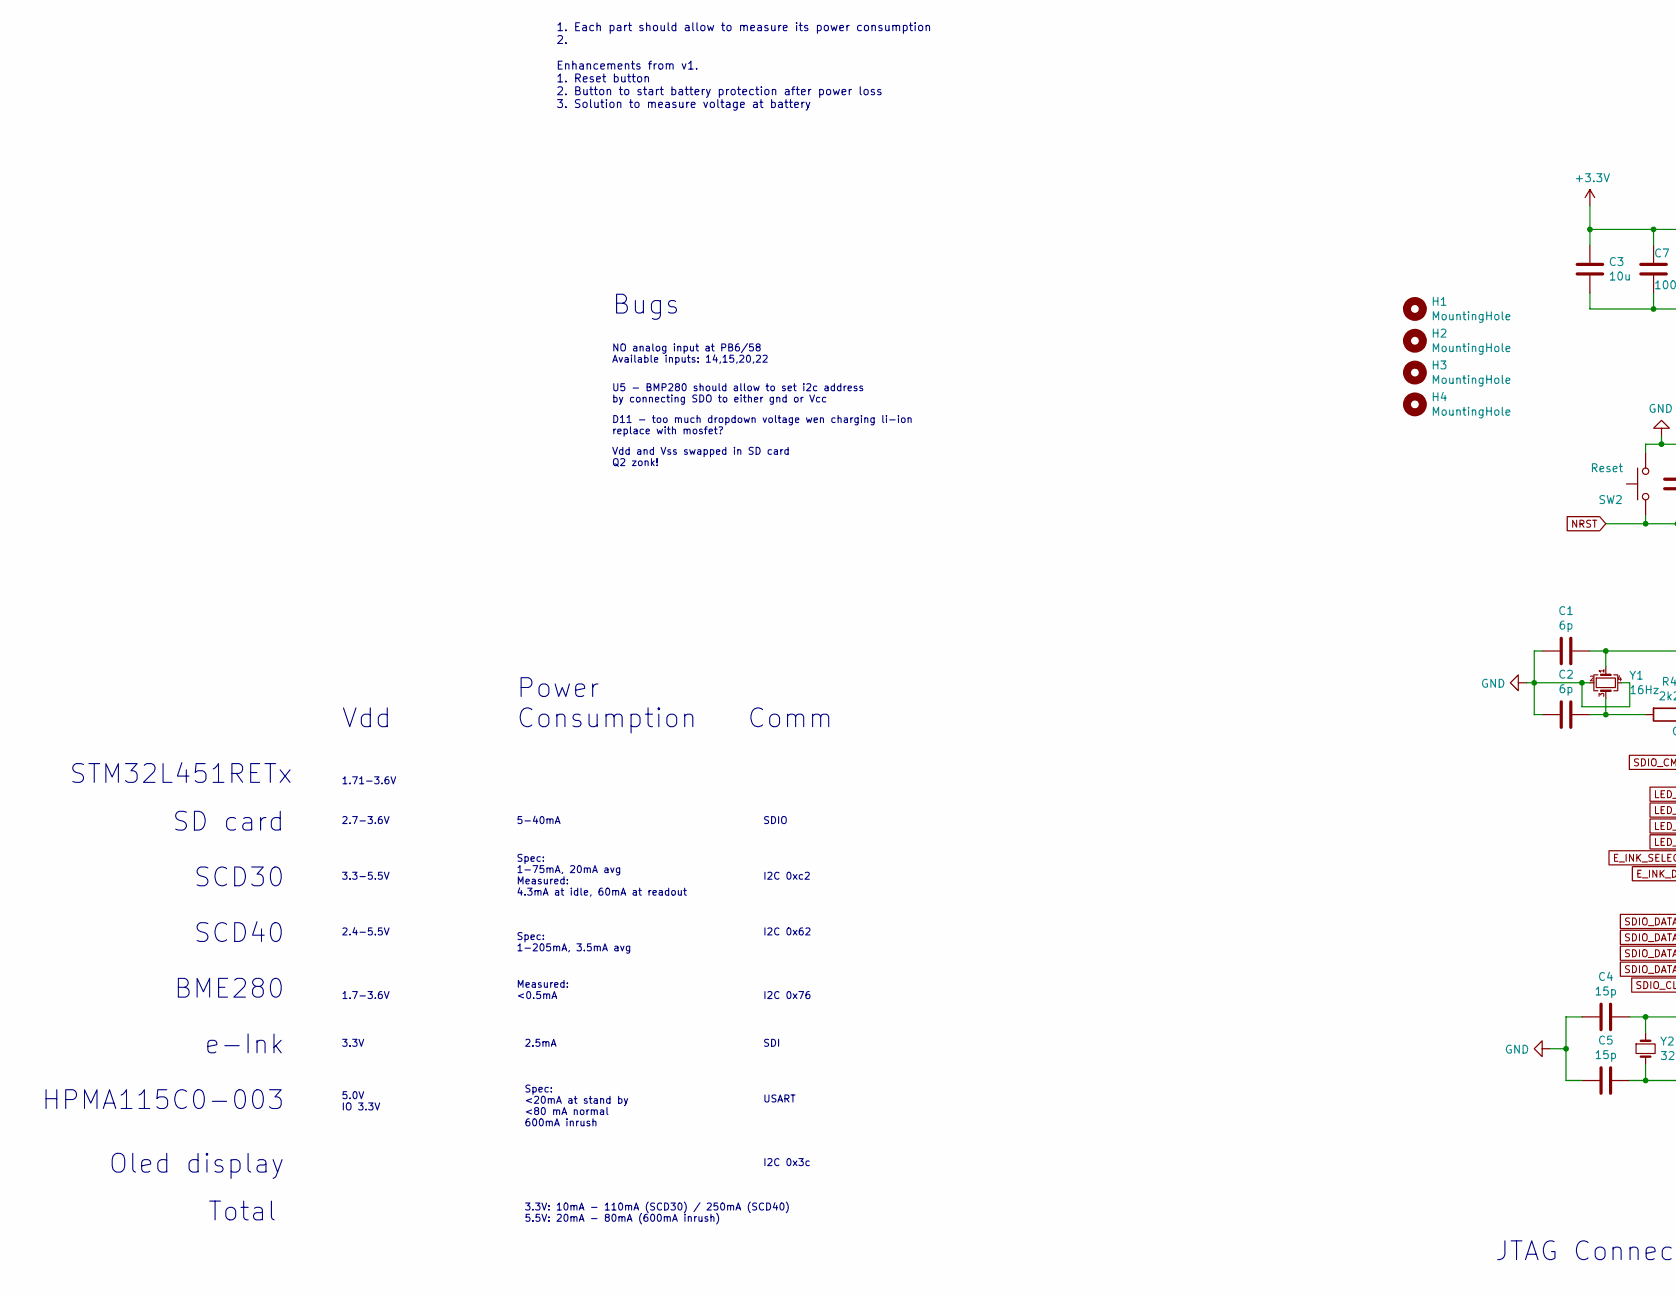
[picture p13: schematic EnvSensor-v2.kicad_sch, part in row 1, column 1]

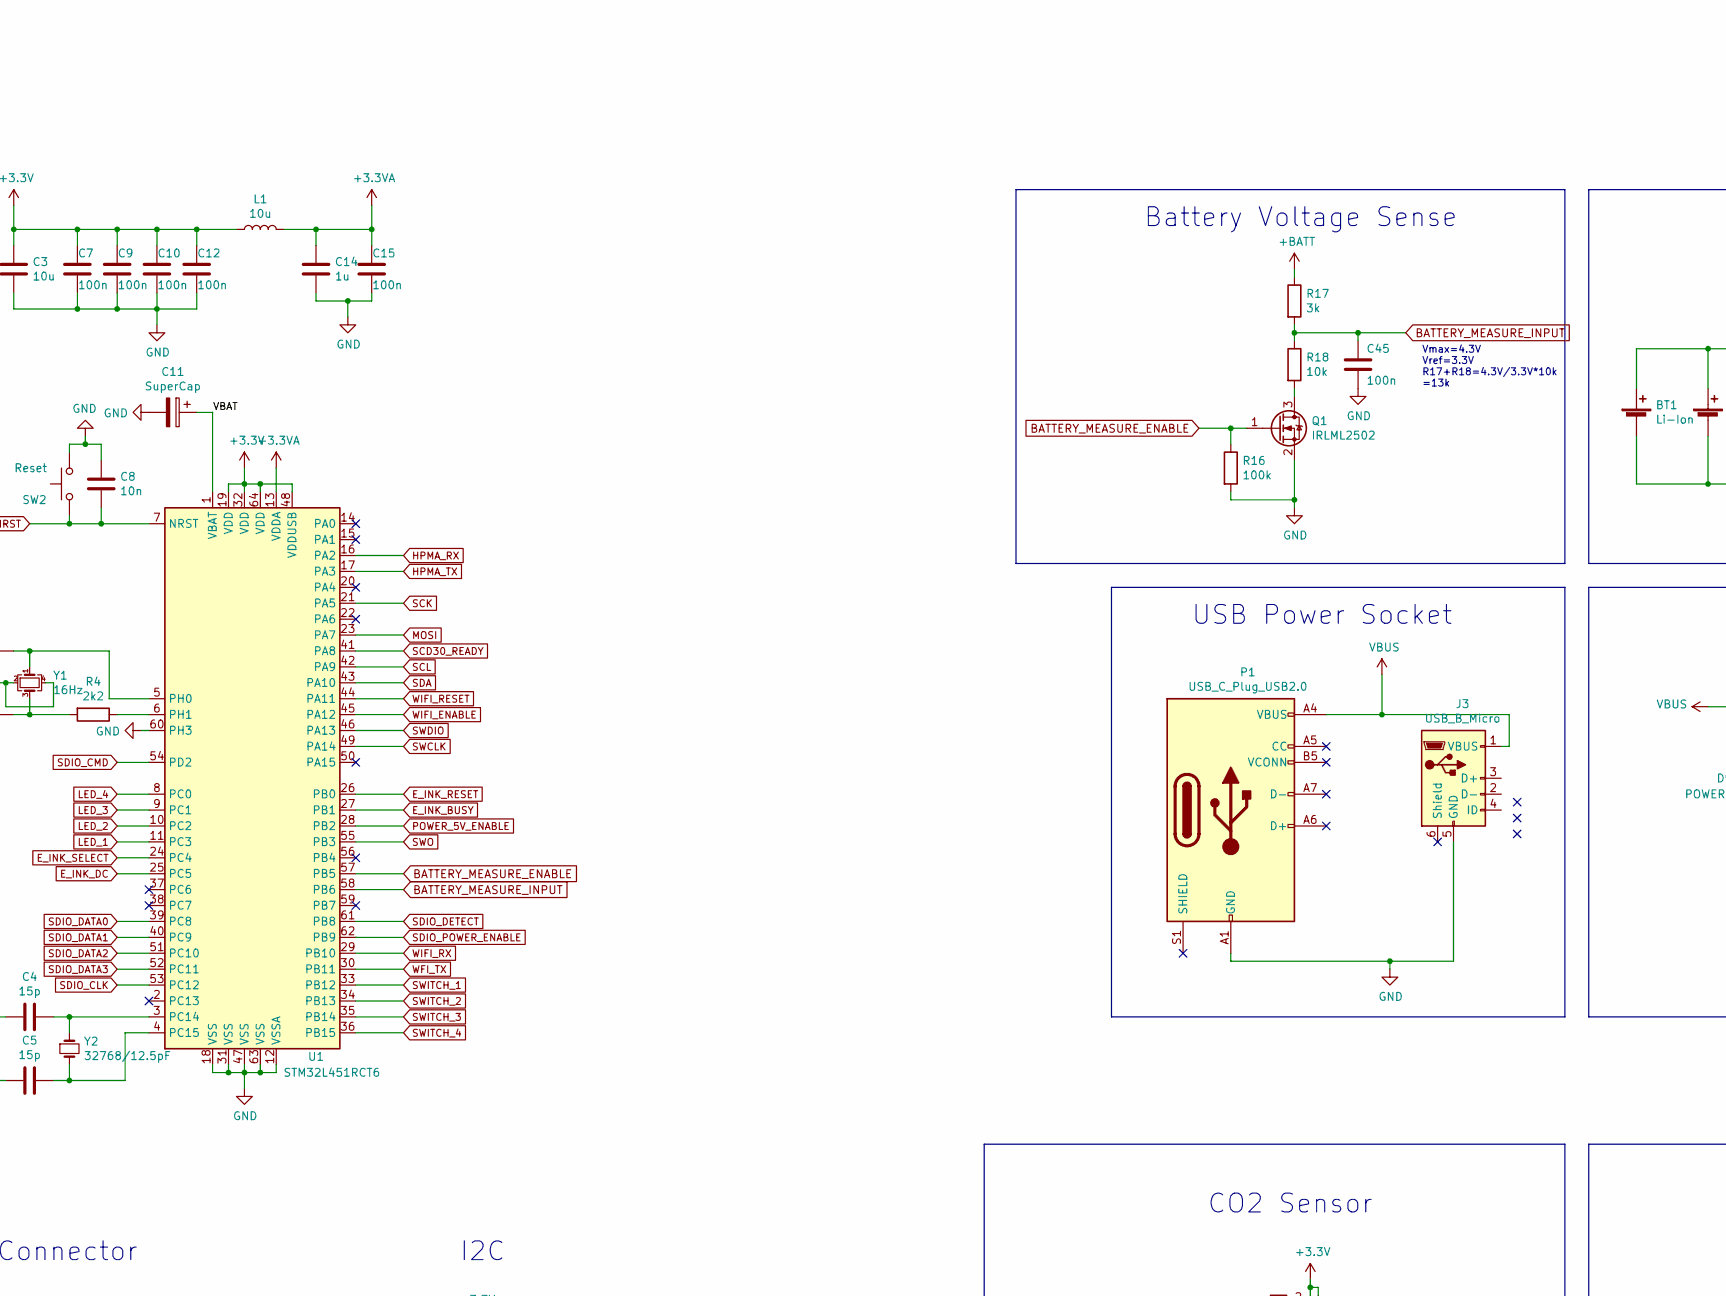
[picture p14: schematic EnvSensor-v2.kicad_sch, part in row 1, column 2]

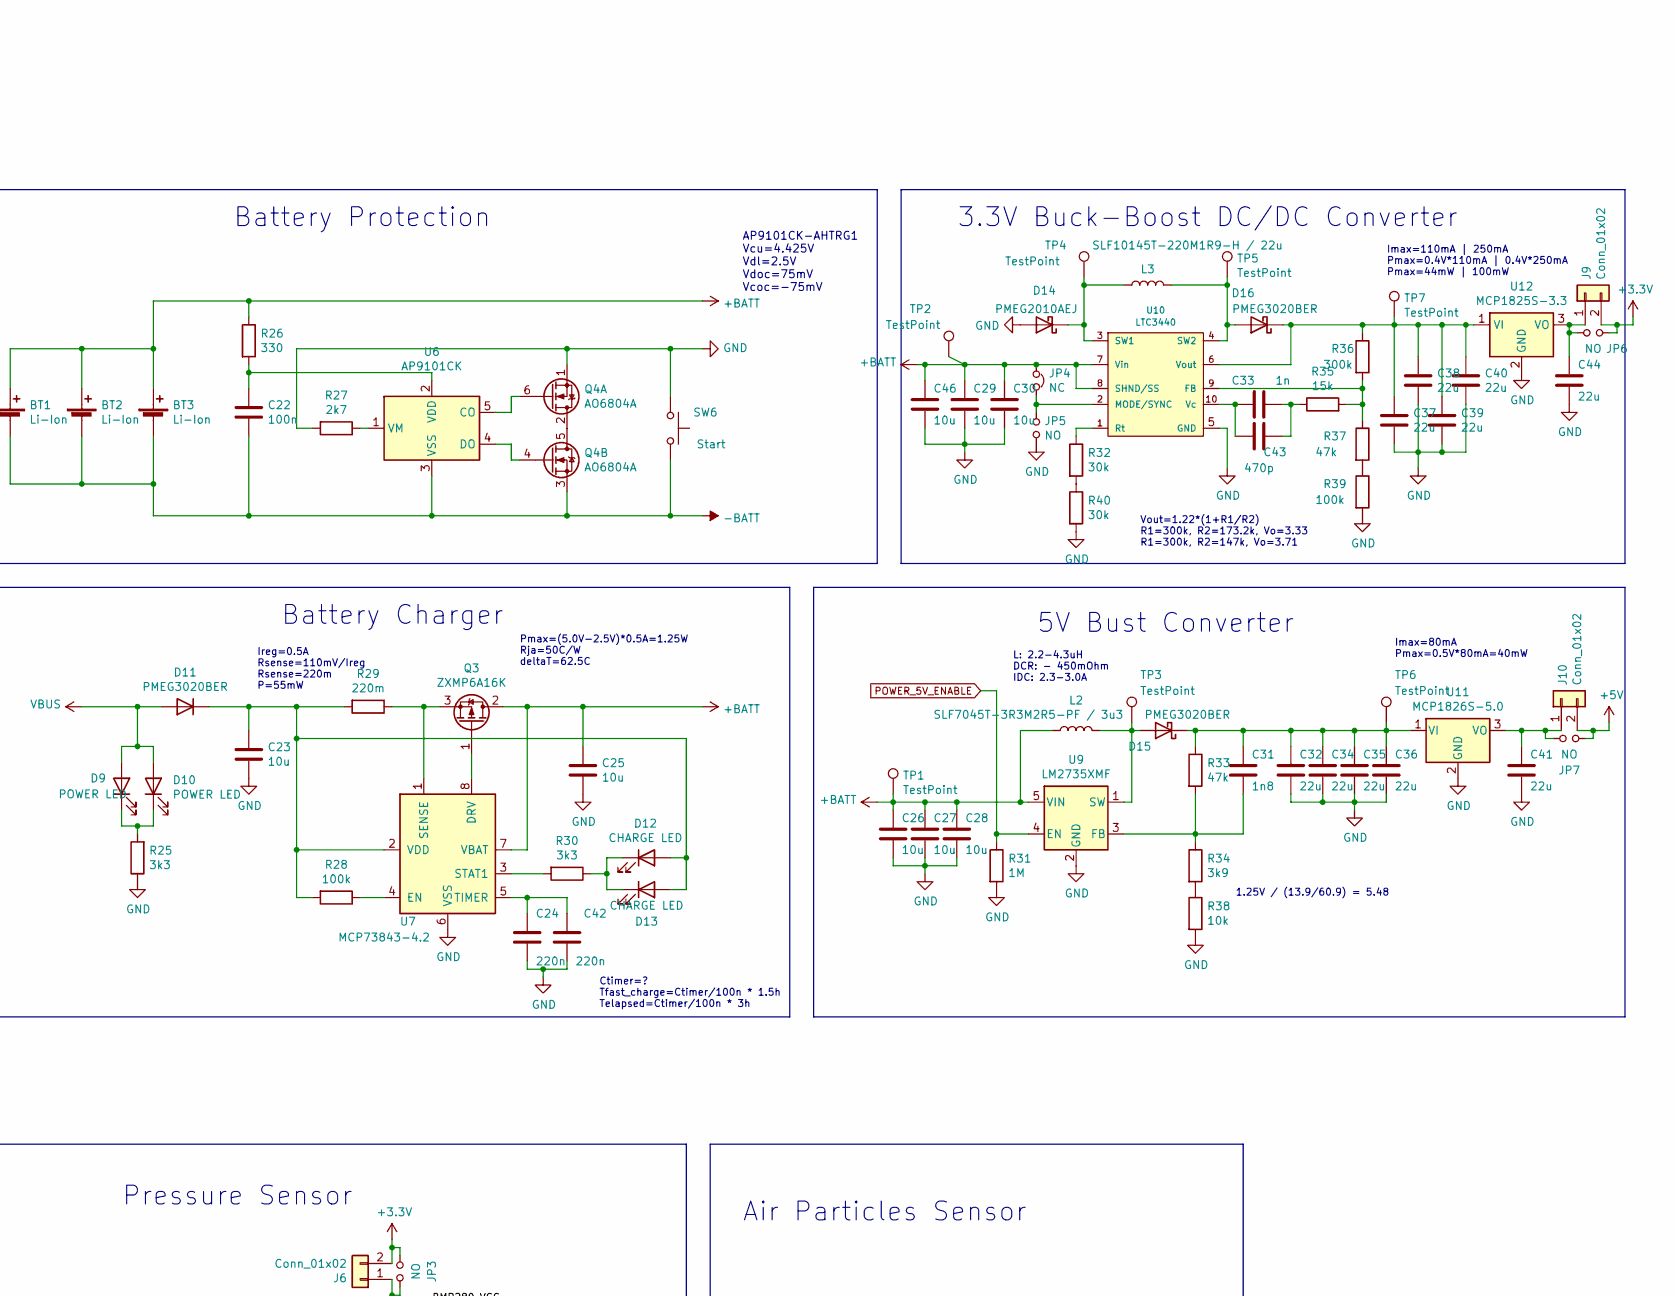
[picture p15: schematic EnvSensor-v2.kicad_sch, part in row 1, column 3]

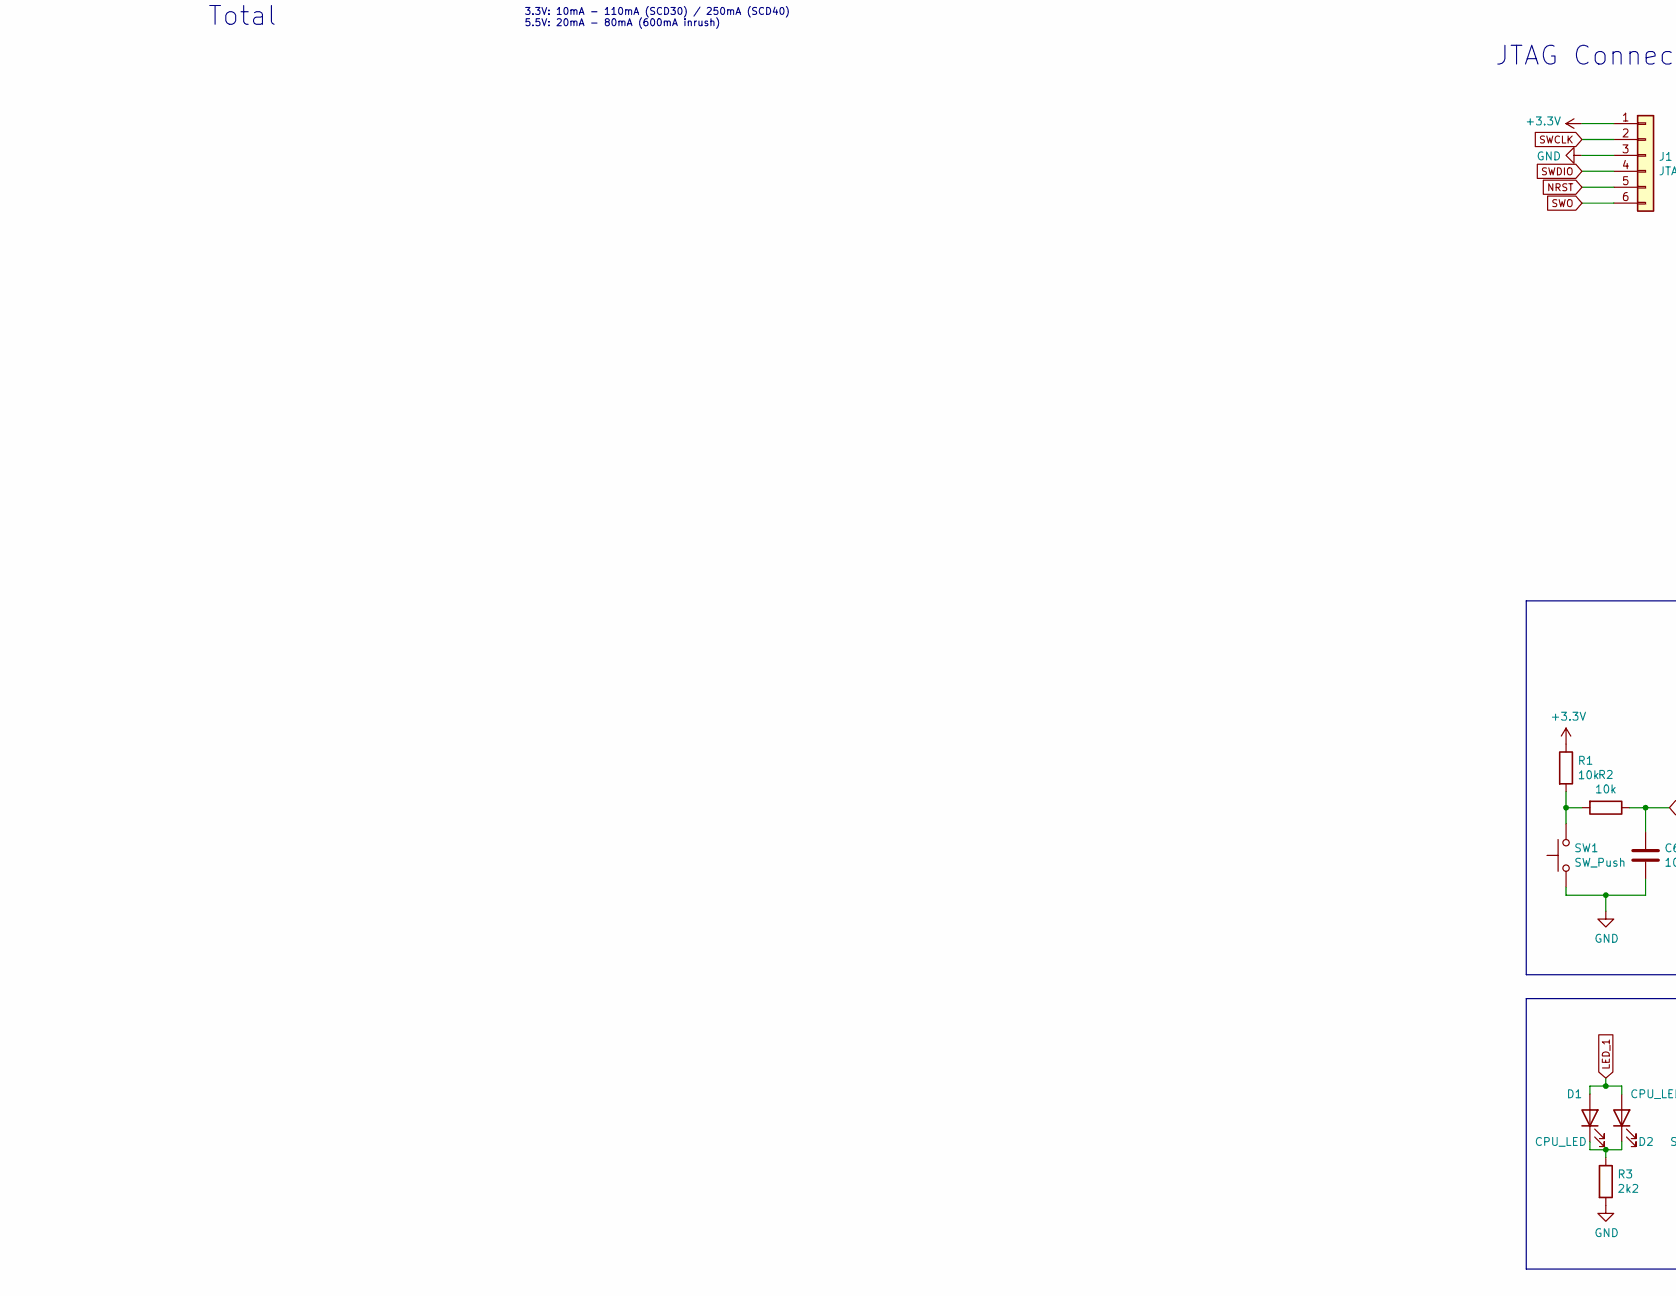
[picture p16: schematic EnvSensor-v2.kicad_sch, part in row 2, column 1]

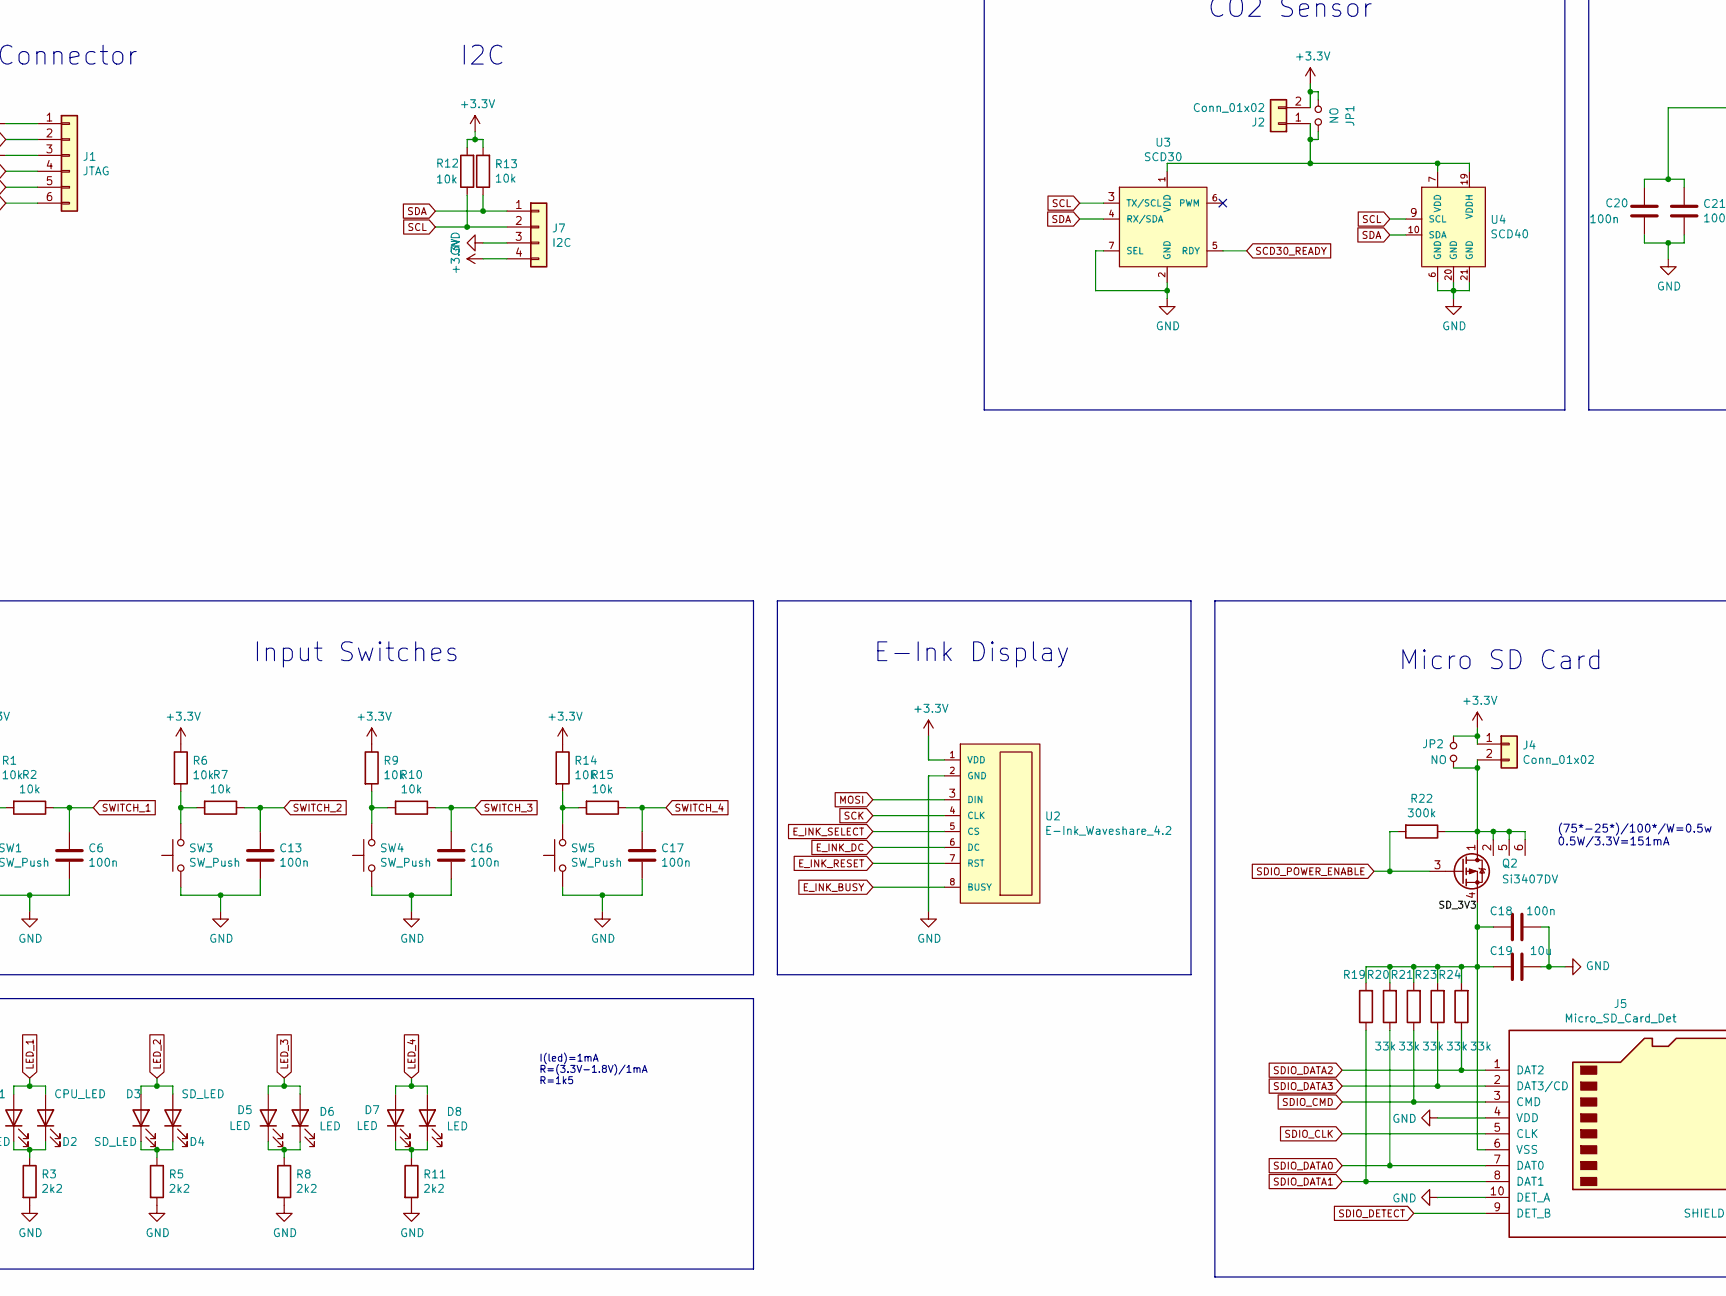
[picture p17: schematic EnvSensor-v2.kicad_sch, part in row 2, column 2]

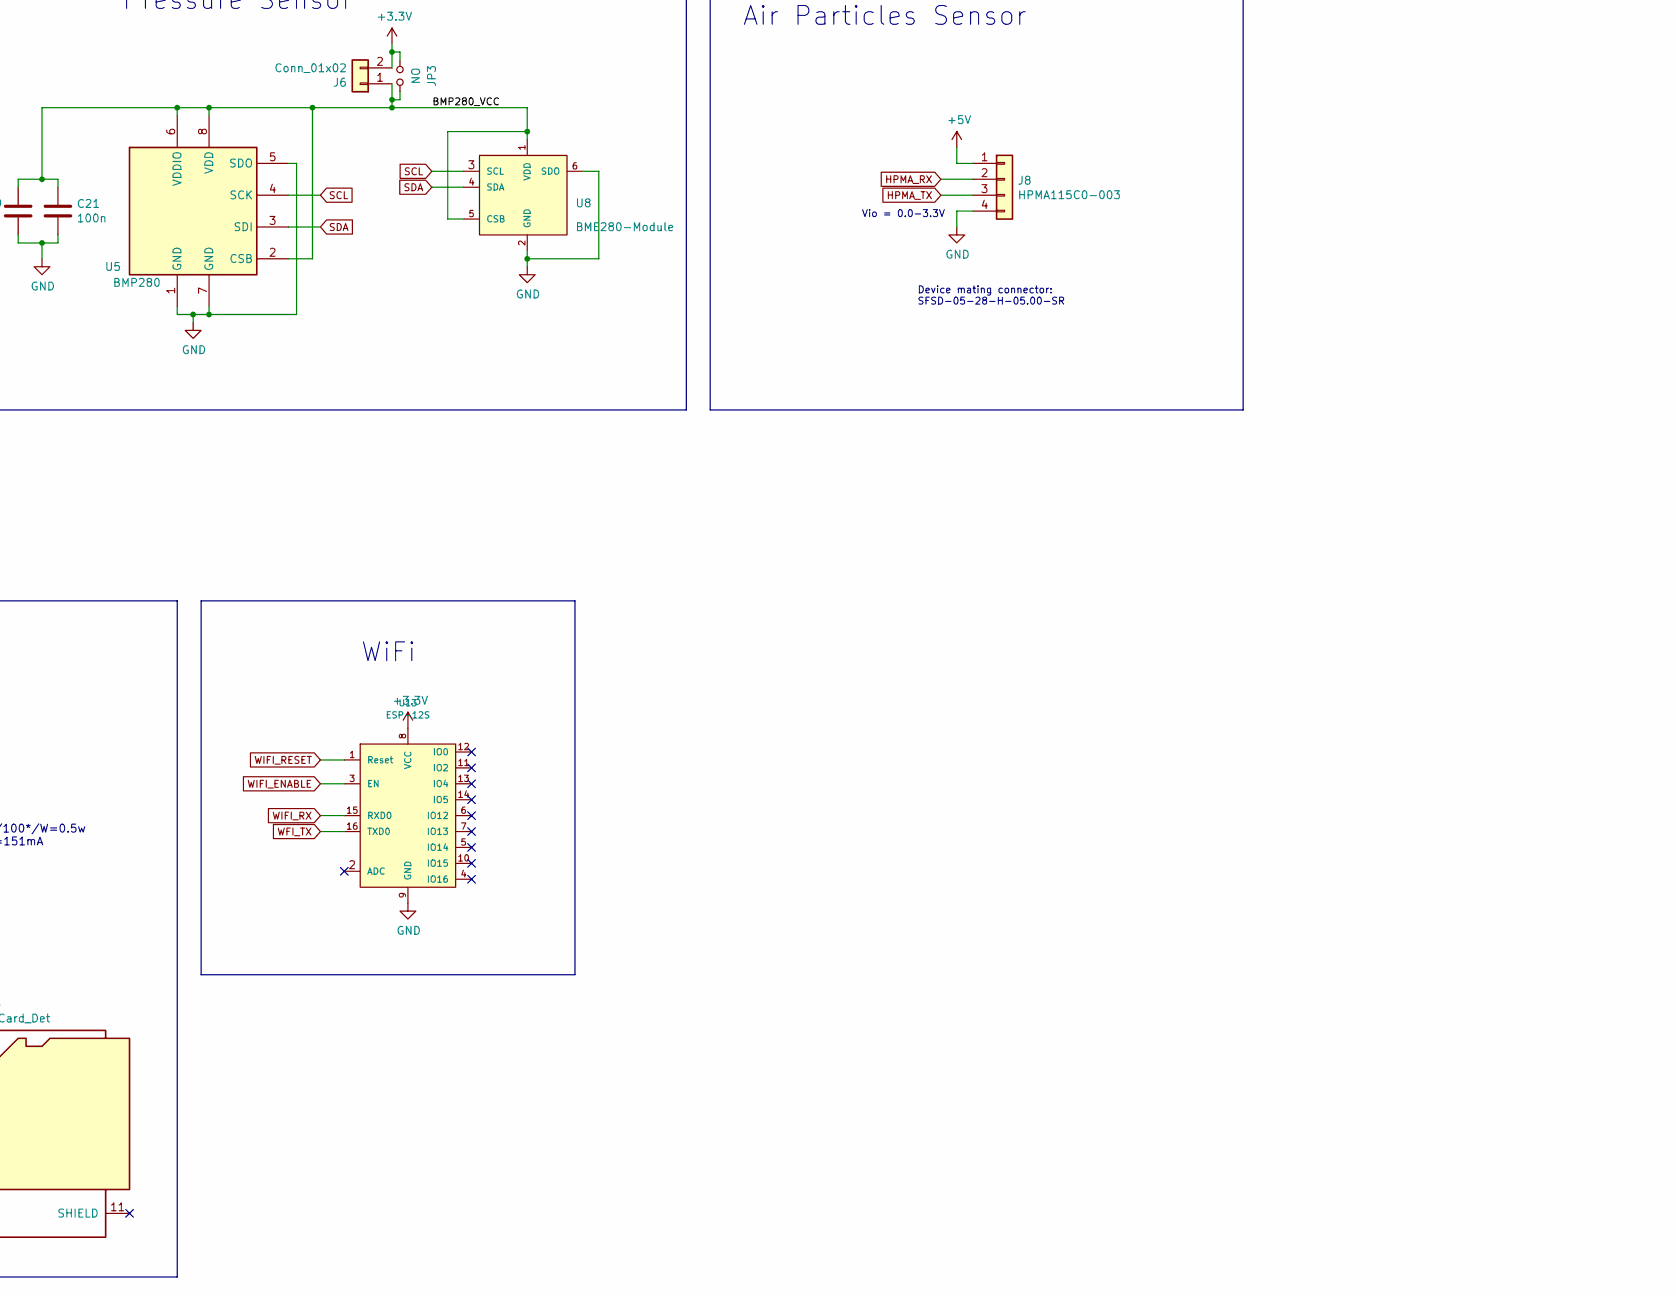
[picture p18: schematic EnvSensor-v2.kicad_sch, part in row 2, column 3]

Parts:
BT1, BT2, BT3: Li-Ion; BatteryHolder_Keystone_1042_1x18650
C1, C2: 6p; C_0805_2012Metric
C3, C19, C23, C25, C26, C27, C28, C29, C30, C46: 10u; C_0805_2012Metric
C4, C5: 15p; C_0805_2012Metric
C6, C7, C9, C10, C12, C13, C15, C16, C17, C18, C20, C21, C22: 100n; C_0603_1608Metric
C8: 10n; C_0805_2012Metric
C11: SuperCap; CP_Elec_10x7.7
C14: 1u; C_0805_2012Metric
C24, C42: 220n; C_0805_2012Metric
C31: 1n8; C_0805_2012Metric
C32, C34, C35, C36, C37, C38, C39, C40, C41, C44: 22u; C_1206_3216Metric
C33: 1n; C_0805_2012Metric
C43: 470p; C_0805_2012Metric
C45: 100n; C_0805_2012Metric
D1: CPU_LED; LED_0805_2012Metric
D2: CPU_LED; LED_D3.0mm
D3: SD_LED; LED_0805_2012Metric
D4: SD_LED; LED_D3.0mm
D5, D7: LED; LED_0805_2012Metric
D6, D8: LED; LED_D3.0mm
D9: POWER LED; LED_0805_2012Metric
D10: POWER LED; LED_D3.0mm_Horizontal_O3.81mm_Z6.0mm
D11, D15, D16: PMEG3020BER; D_SOD-123
D12: CHARGE LED; LED_0805_2012Metric
D13: CHARGE LED; LED_D3.0mm_Horizontal_O3.81mm_Z6.0mm
D14: PMEG2010AEJ; D_SOD-323_HandSoldering
H1, H2, H3, H4: MountingHole; MountingHole_3.2mm_M3
J1: JTAG; PinHeader_1x06_P2.54mm_Vertical
J2, J4, J6, J9, J10: Conn_01x02; PinHeader_1x02_P2.54mm_Vertical
J3: USB_B_Micro; USB_Micro-B_Molex_47346-0001
J5: Micro_SD_Card_Det; microSD_HC_Hirose_DM3AT-SF-PEJM5
J7: I2C; PinSocket_1x04_P2.54mm_Vertical
J8: HPMA115C0-003; PinHeader_1x04_P2.54mm_Vertical
JP1, JP2, JP3, JP5, JP6, JP7: NO; SolderJumper-2_P1.3mm_Open_RoundedPad1.0x1.5mm
JP4: NC; SolderJumper-2_P1.3mm_Bridged_RoundedPad1.0x1.5mm
L1: 10u; L_0805_2012Metric
L2: SLF7045T-3R3M2R5-PF / 3u3; L_TDK_SLF7045
L3: SLF10145T-220M1R9-H / 22u; L_TDK_SLF10145
P1: USB_C_Plug_USB2.0; USB_C_Receptacle_Adam_Tech
Q1: IRLML2502; SOT-23
Q2: Si3407DV; TSOT-23-6
Q3: ZXMP6A16K; TO-252-2
Q4: AO6804A; TSOT-23-6
R1, R2, R6, R7, R9, R10, R14, R15: 10k; R_0603_1608Metric
R3, R4, R5, R8, R11: 2k2; R_0805_2012Metric
R12, R13, R18, R38: 10k; R_0805_2012Metric
R16, R39: 100k; R_0805_2012Metric
R17: 3k; R_0805_2012Metric
R19, R20, R21, R23, R24: 33k; R_0805_2012Metric
R22, R36: 300k; R_0805_2012Metric
R25, R30: 3k3; R_0805_2012Metric
R26: 330; R_0805_2012Metric
R27: 2k7; R_0805_2012Metric
R28: 100k; R_0603_1608Metric
R29: 220m; R_1206_3216Metric
R31: 1M; R_0805_2012Metric
R32, R40: 30k; R_0805_2012Metric
R33, R37: 47k; R_0805_2012Metric
R34: 3k9; R_0805_2012Metric
R35: 15k; R_0805_2012Metric
SW1, SW3, SW4, SW5: SW_Push; SW_SPST_PTS645
SW2: Reset; SW_Tactile_SKHH_Angled
SW6: Start; SW_SPST_CK_RS282G05A3
TP1, TP2, TP3, TP4, TP5, TP6, TP7: TestPoint; TestPoint_THTPad_D1.5mm_Drill0.7mm
U1: STM32L451RCT6; LQFP-64_10x10mm_P0.5mm
U2: E-Ink_Waveshare_4.2; 4.2inch_E-Ink
U3: SCD30
U4: SCD40; SCD4x
U5: BMP280; Bosch_LGA-8_2.5x2.5mm_P0.65mm_ClockwisePinNumbering
U6: AP9101CK; SOT-23-5
U7: MCP73843-4.2; MSOP-8_3x3mm_P0.65mm
U8: BME280-Module
U9: LM2735XMF; SOT-23-5
U10: LTC3440; MSOP-10_3x3mm_P0.5mm
U11: MCP1826S-5.0; SOT-223-3_TabPin2
U12: MCP1825S-3.3; SOT-223-3_TabPin2
U13: ESP-12S
Y1: 16Hz; Crystal_SMD_Abracon_ABM3B-4Pin_5.0x3.2mm
Y2: 32768/12.5pF; Crystal_SMD_MicroCrystal_CC7V-T1A-2Pin_3.2x1.5mm

Connections:
+3.3VA: C14.1, C15.1, L1.2, U1.13 (VDDA)
+3V3: C3.1, C7.1, C9.1, C10.1, C12.1, J1.1, J2.2, J4.1, J6.2, J7.4, J9.2, JP1.2, JP2.1, JP3.2, JP6.2, L1.1, R1.1, R6.1, R9.1, R12.2, R13.2, R14.1, U1.19 (VDD), U1.32 (VDD), U1.48 (VDDUSB), U1.64 (VDD), U2.1 (VDD), U13.8 (VCC)
+5V: J8.1, J10.2, JP7.2
+BATT: BT1.1 (+), BT2.1 (+), BT3.1 (+), C25.1, C26.1, C27.1, C28.1, C29.1, C30.1, C46.1, JP4.1, L2.1, Q3.2 (D), R17.1, R26.1, TP1.1, TP2.1, U7.7 (VBAT), U9.5 (VIN), U10.7 (Vin), U10.8 (SHND/SS)
-BATT: BT1.2 (-), BT2.2 (-), BT3.2 (-), C22.2, Q4.3 (S2), SW6.1, U6.3 (VSS)
/BMP280_VCC: C20.1, C21.1, J6.1, JP3.1, U5.2 (CSB), U5.6 (VDDIO), U5.8 (VDD), U8.1 (VDD), U8.5 (CSB)
/SD_3V3: C18.2, C19.2, J5.6 (VSS), Q2.4 (S), R19.2, R20.2, R21.2, R23.2, R24.2
/VBAT: C11.1, U1.1 (VBAT)
BATTERY_MEASURE_ENABLE: Q1.1 (G), R16.1, U1.57 (PB5)
BATTERY_MEASURE_INPUT: C45.1, R17.2, R18.1, U1.58 (PB6)
E_INK_BUSY: U1.27 (PB1), U2.8 (BUSY)
E_INK_DC: U1.25 (PC5), U2.6 (DC)
E_INK_RESET: U1.26 (PB0), U2.7 (RST)
E_INK_SELECT: U1.24 (PC4), U2.5 (CS)
GND: C1.2, C2.2, C3.2, C4.2, C5.2, C6.2, C7.2, C8.1, C9.2, C10.2, C11.2, C12.2, C13.2, C14.2, C15.2, C16.2, C17.2, C18.1, C19.1, C20.2, C21.2, C23.2, C24.2, C25.2, C26.2, C27.2, C28.2, C29.2, C30.2, C32.2, C34.2, C35.2, C36.2, C37.2, C38.2, C39.2, C40.2, C41.2, C42.2, C44.2, C45.2, C46.2, D14.2 (A), J1.3, J3.5 (GND), J5.4 (VDD), J5.10 (DET_A), J7.3, J8.4, JP5.2, P1.A1 (GND), P1.A12 (GND), P1.B1 (GND), P1.B12 (GND), Q1.2 (S), Q4.1 (S2), R3.2, R5.2, R8.2, R11.2, R16.2, R25.1, R27.2, R31.2, R38.2, R39.2, R40.2, SW1.1, SW2.1, SW3.1, SW4.1, SW5.1, SW6.2, U1.12 (VSSA), U1.18 (VSS), U1.31 (VSS), U1.47 (VSS), U1.60 (PH3), U1.63 (VSS), U2.2 (GND), U3.2 (GND), U3.7 (SEL), U4.6 (GND), U4.20 (GND), U4.21 (GND), U5.1 (GND), U5.5 (SDO), U5.7 (GND), U7.6 (VSS), U8.2 (GND), U8.6 (SDO), U9.2 (GND), U10.5 (GND), U11.2 (GND), U12.2 (GND), U13.9 (GND), Y1.2, Y1.4
HPMA_RX: J8.2, U1.16 (PA2)
HPMA_TX: J8.3, U1.17 (PA3)
LED_1: D1.2 (A), D2.2 (A), U1.11 (PC3)
LED_2: D3.2 (A), D4.2 (A), U1.10 (PC2)
LED_3: D5.2 (A), D6.2 (A), U1.9 (PC1)
LED_4: D7.2 (A), D8.2 (A), U1.8 (PC0)
MOSI: U1.23 (PA7), U2.3 (DIN)
NRST: C8.2, J1.5, SW2.2, U1.7 (NRST)
unnamed: C1.1, U1.5 (PH0), Y1.1
unnamed: C2.1, R4.2, Y1.3
unnamed: C4.1, U1.3 (PC14), Y2.1
unnamed: C5.1, U1.4 (PC15), Y2.2
unnamed: C22.1, R26.2, U6.2 (VDD)
unnamed: C23.1, D11.1 (K), D12.2 (A), D13.2 (A), R28.2, R29.2, U7.2 (VDD)
unnamed: C24.1, C42.1, U7.5 (TIMER)
unnamed: C31.1, C32.1, C34.1, C35.1, C36.1, D15.1 (K), R33.1, TP6.1, U11.1 (VI)
unnamed: C31.2, R33.2, R34.1, U9.3 (FB)
unnamed: C33.1, C43.1, R35.1
unnamed: C33.2, C43.2, U10.10 (Vc)
unnamed: C37.1, C38.1, C39.1, C40.1, D16.1 (K), R36.1, TP7.1, U10.6 (Vout), U12.1 (VI)
unnamed: C41.1, J10.1, JP7.1, U11.3 (VO)
unnamed: C44.1, J9.1, JP6.1, U12.3 (VO)
unnamed: D1.1 (K), D2.1 (K), R3.1
unnamed: D3.1 (K), D4.1 (K), R5.1
unnamed: D5.1 (K), D6.1 (K), R8.1
unnamed: D7.1 (K), D8.1 (K), R11.1
unnamed: D9.1 (K), D10.1 (K), R25.2
unnamed: D12.1 (K), D13.1 (K), R30.1
unnamed: D14.1 (K), L3.1, TP4.1, U10.3 (SW1)
unnamed: D15.2 (A), L2.2, TP3.1, U9.1 (SW)
unnamed: D16.2 (A), L3.2, TP5.1, U10.4 (SW2)
unnamed: J2.1, JP1.1, U3.1 (VDD), U4.7 (VDD), U4.19 (VDDH)
unnamed: J4.2, JP2.2, Q2.1 (D), Q2.2 (D), Q2.5 (D), Q2.6 (D), R22.1
unnamed: JP4.2, JP5.1, U10.2 (MODE/SYNC)
unnamed: Q1.3 (D), R18.2
unnamed: Q3.1 (G), U7.8 (DRV)
unnamed: Q3.3 (S), R29.1, U7.1 (SENSE)
unnamed: Q4.2 (D2), Q4.5 (D2)
unnamed: Q4.4 (G2), U6.4 (DO)
unnamed: Q4.6 (G2), U6.5 (CO)
unnamed: R1.2, R2.2, SW1.2
unnamed: R4.1, U1.6 (PH1)
unnamed: R6.2, R7.2, SW3.2
unnamed: R9.2, R10.2, SW4.2
unnamed: R14.2, R15.2, SW5.2
unnamed: R27.1, U6.1 (VM)
unnamed: R28.1, U7.4 (EN)
unnamed: R30.2, U7.3 (STAT1)
unnamed: R32.1, U10.1 (Rt)
unnamed: R32.2, R40.1
unnamed: R34.2, R38.1
unnamed: R35.2, R36.2, R37.1, U10.9 (FB)
unnamed: R37.2, R39.1
POWER_5V_ENABLE: R31.1, U1.28 (PB2), U9.4 (EN)
SCD30_READY: U1.41 (PA8), U3.5 (RDY)
SCK: U1.21 (PA5), U2.4 (CLK)
SCL: J7.2, R12.1, U1.42 (PA9), U3.3 (TX/SCL), U4.9 (SCL), U5.4 (SCK), U8.3 (SCL)
SDA: J7.1, R13.1, U1.43 (PA10), U3.4 (RX/SDA), U4.10 (SDA), U5.3 (SDI), U8.4 (SDA)
SDIO_CLK: J5.5 (CLK), U1.53 (PC12)
SDIO_CMD: J5.3 (CMD), R21.1, U1.54 (PD2)
SDIO_DATA0: J5.7 (DAT0), R20.1, U1.39 (PC8)
SDIO_DATA1: J5.8 (DAT1), R19.1, U1.40 (PC9)
SDIO_DATA2: J5.1 (DAT2), R24.1, U1.51 (PC10)
SDIO_DATA3: J5.2 (DAT3/CD), R23.1, U1.52 (PC11)
SDIO_DETECT: J5.9 (DET_B), U1.61 (PB8)
SDIO_POWER_ENABLE: Q2.3 (G), R22.2, U1.62 (PB9)
SWCLK: J1.2, U1.49 (PA14)
SWDIO: J1.4, U1.46 (PA13)
SWITCH_1: C6.1, R2.1, U1.33 (PB12)
SWITCH_2: C13.1, R7.1, U1.34 (PB13)
SWITCH_3: C16.1, R10.1, U1.35 (PB14)
SWITCH_4: C17.1, R15.1, U1.36 (PB15)
SWO: J1.6, U1.55 (PB3)
VBUS: D9.2 (A), D10.2 (A), D11.2 (A), J3.1 (VBUS), P1.A4 (VBUS), P1.A9 (VBUS), P1.B4 (VBUS), P1.B9 (VBUS)
WFI_TX: U1.30 (PB11), U13.16 (TXD0)
WIFI_ENABLE: U1.45 (PA12), U13.3 (EN)
WIFI_RESET: U1.44 (PA11), U13.1 (Reset)
WIFI_RX: U1.29 (PB10), U13.15 (RXD0)

Notes on the sheet:
Micro SD Card
e-Ink
L: 2.2-4.3uH DCR: - 450mOhm IDC: 2.3-3.0A
AP9101CK-AHTRG1 Vcu=4.425V Vdl=2.5V Vdoc=75mV Vcoc=-75mV
I2C 0x76
I2C 0x62
3.3-5.5V
D11 - too much dropdown voltage wen charging li-ion replace with mosfet?
1. Each part should allow to measure its power consumption 2. Enhancements from v1. 1. Reset button 2. Button to start battery protection after power loss 3. Solution to measure voltage at battery
Battery Charger
Vdd and Vss swapped in SD card Q2 zonk!
Vmax=4.3V Vref=3.3V R17+R18=4.3V/3.3V*10k =13k
SDIO
WiFi
CO2 Sensor
Measured: <0.5mA
5V Bust Converter
Ireg=0.5A Rsense=110mV/Ireg Rsense=220m P=55mW
Total
1.71-3.6V
SD card
I2C
Pmax=(5.0V-2.5V)*0.5A=1.25W Rja=50C/W deltaT=62.5C
Input Switches
Pressure Sensor
SDI
3.3V: 10mA - 110mA (SCD30) / 250mA (SCD40) 5.5V: 20mA - 80mA (600mA inrush)
5-40mA
Power Consumption
Device mating connector: SFSD-05-28-H-05.00-SR
3.3V Buck-Boost DC/DC Converter
SCD40
E-Ink Display
2.7-3.6V
2.5mA
Imax=110mA | 250mA Pmax=0.4V*110mA | 0.4V*250mA Pmax=44mW | 100mW
Battery Voltage Sense
5.0V IO 3.3V
USB Power Socket
I2C 0x3c
Spec: 1-75mA, 20mA avg Measured: 4.3mA at idle, 60mA at readout
Vdd
Vio = 0.0-3.3V
3.3V
Ctimer=? Tfast_charge=Ctimer/100n * 1.5h Telapsed=Ctimer/100n * 3h
Comm
U5 - BMP280 should allow to set i2c address by connecting SDO to either gnd or Vcc
SCD30
2.4-5.5V
Bugs
Vout=1.22*(1+R1/R2) R1=300k, R2=173.2k, Vo=3.33 R1=300k, R2=147k, Vo=3.71
NO analog input at PB6/58 Available inputs: 14,15,20,22
HPMA115C0-003
Spec: 1-205mA, 3.5mA avg
Imax=80mA Pmax=0.5V*80mA=40mW
Air Particles Sensor
I(led)=1mA R=(3.3V-1.8V)/1mA R=1k5
JTAG Connector
BME280
Spec: <20mA at stand by <80 mA normal 600mA inrush
STM32L451RETx
(75*-25*)/100*/W=0.5w 0.5W/3.3V=151mA
USART
1.7-3.6V
1.25V / (13.9/60.9) = 5.48
I2C 0xc2
Oled display
Battery Protection

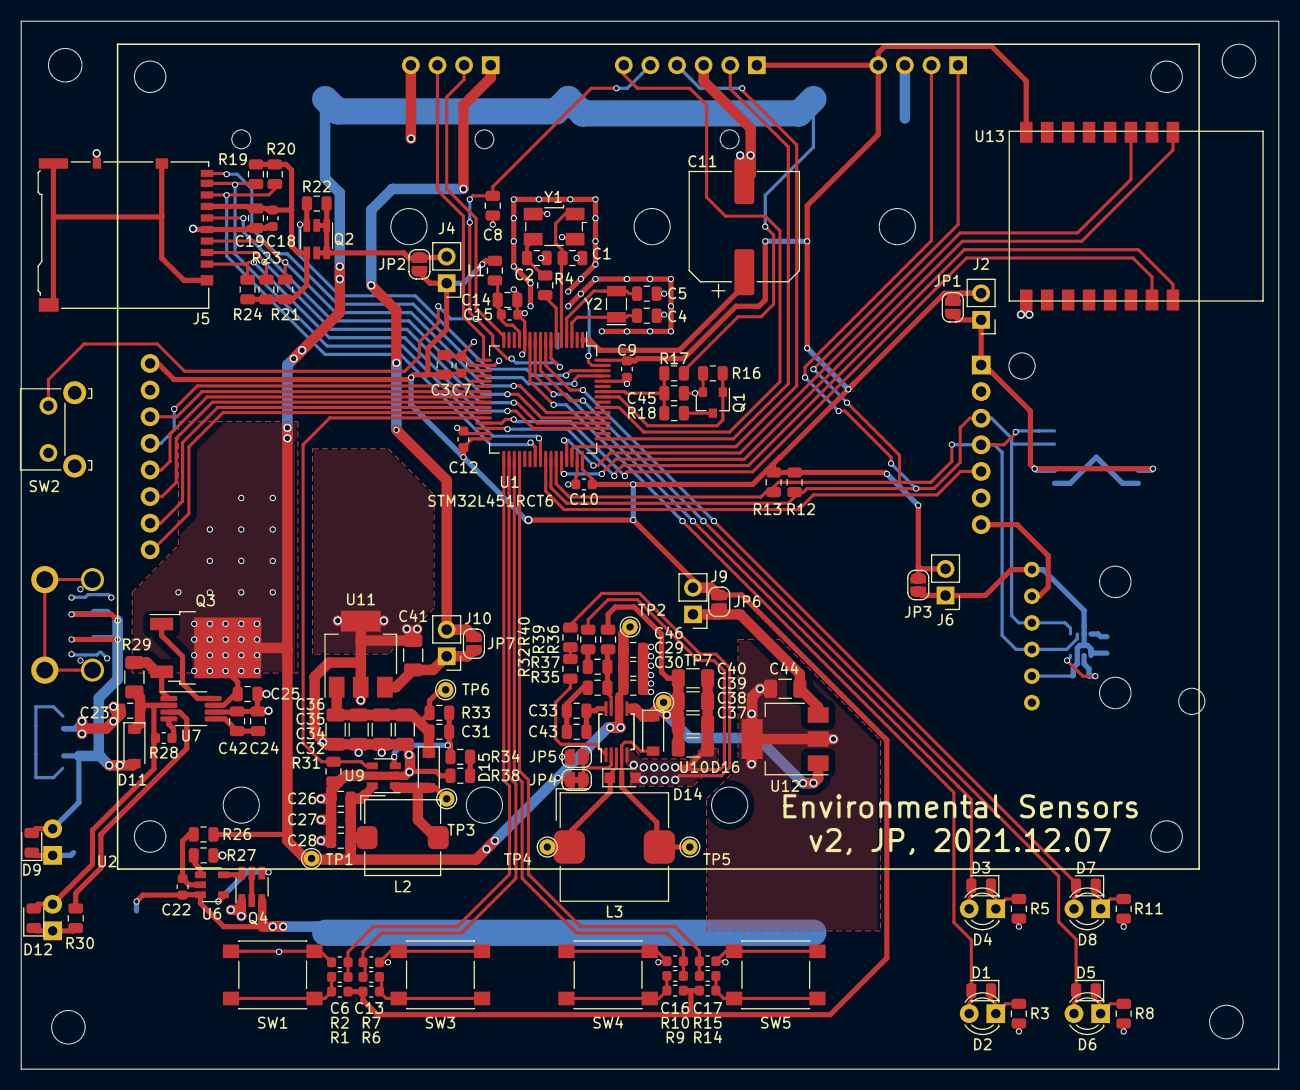
[picture p19: board EnvSensor-v2.kicad_pcb from above]

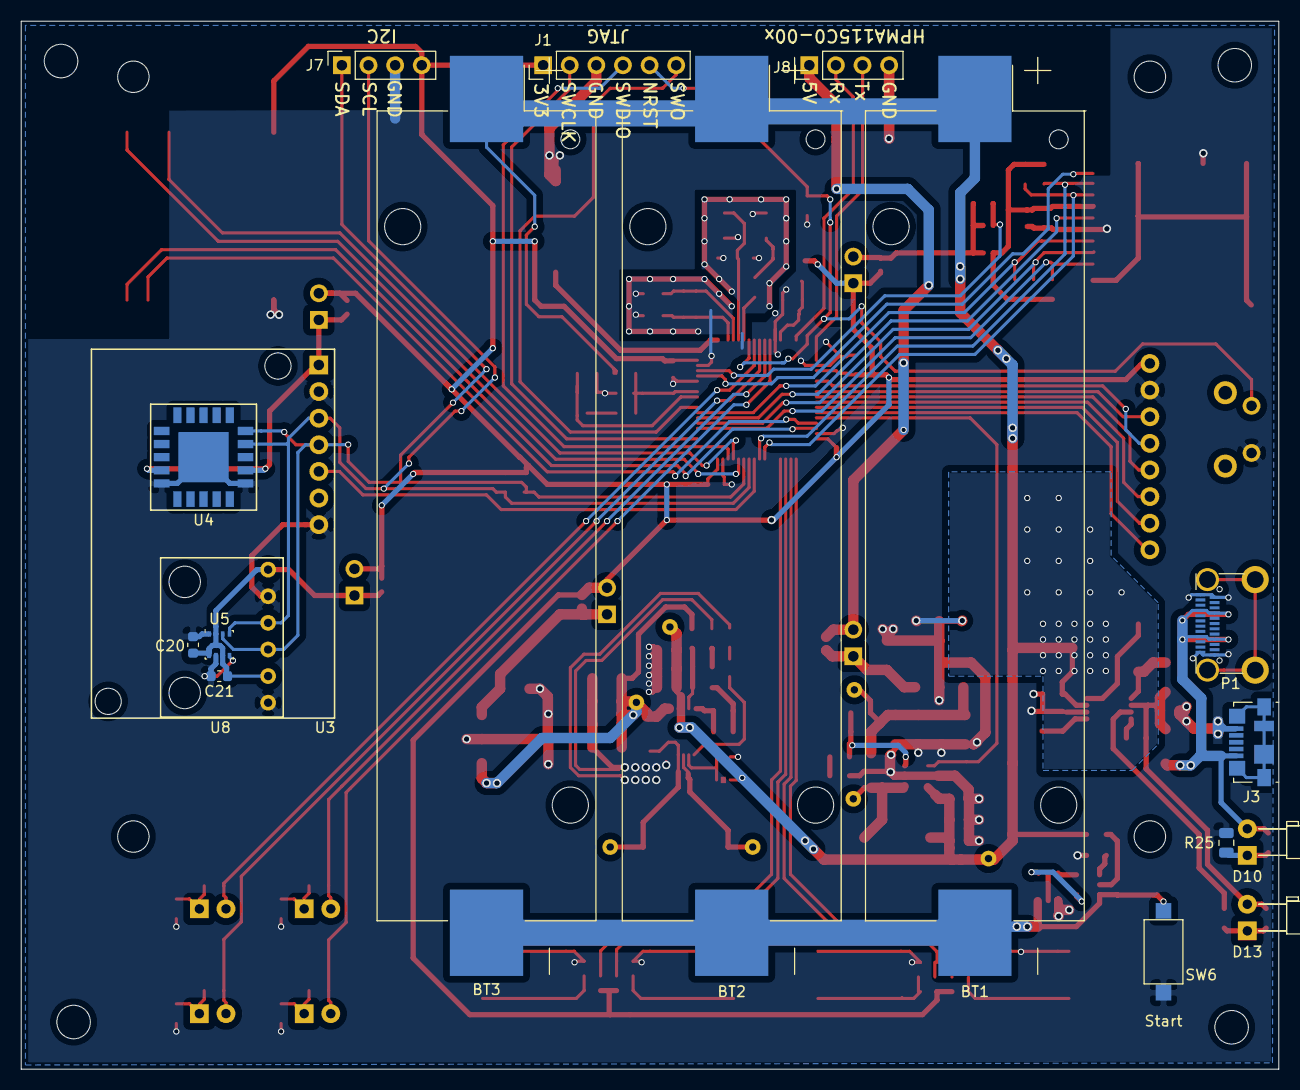
[picture p20: board EnvSensor-v2.kicad_pcb from below]

Board: 2 copper layers, 120.0 x 100.0 mm, 162 parts (18 on the bottom side), 93 nets.
