jakubprzybytek/Environmental-Sensors/KiCad/EnvSensor/EnvSensor.kicad_pcb

## KiCad design KiCad/EnvSensor/EnvSensor.kicad_pcb (2021-01-01)

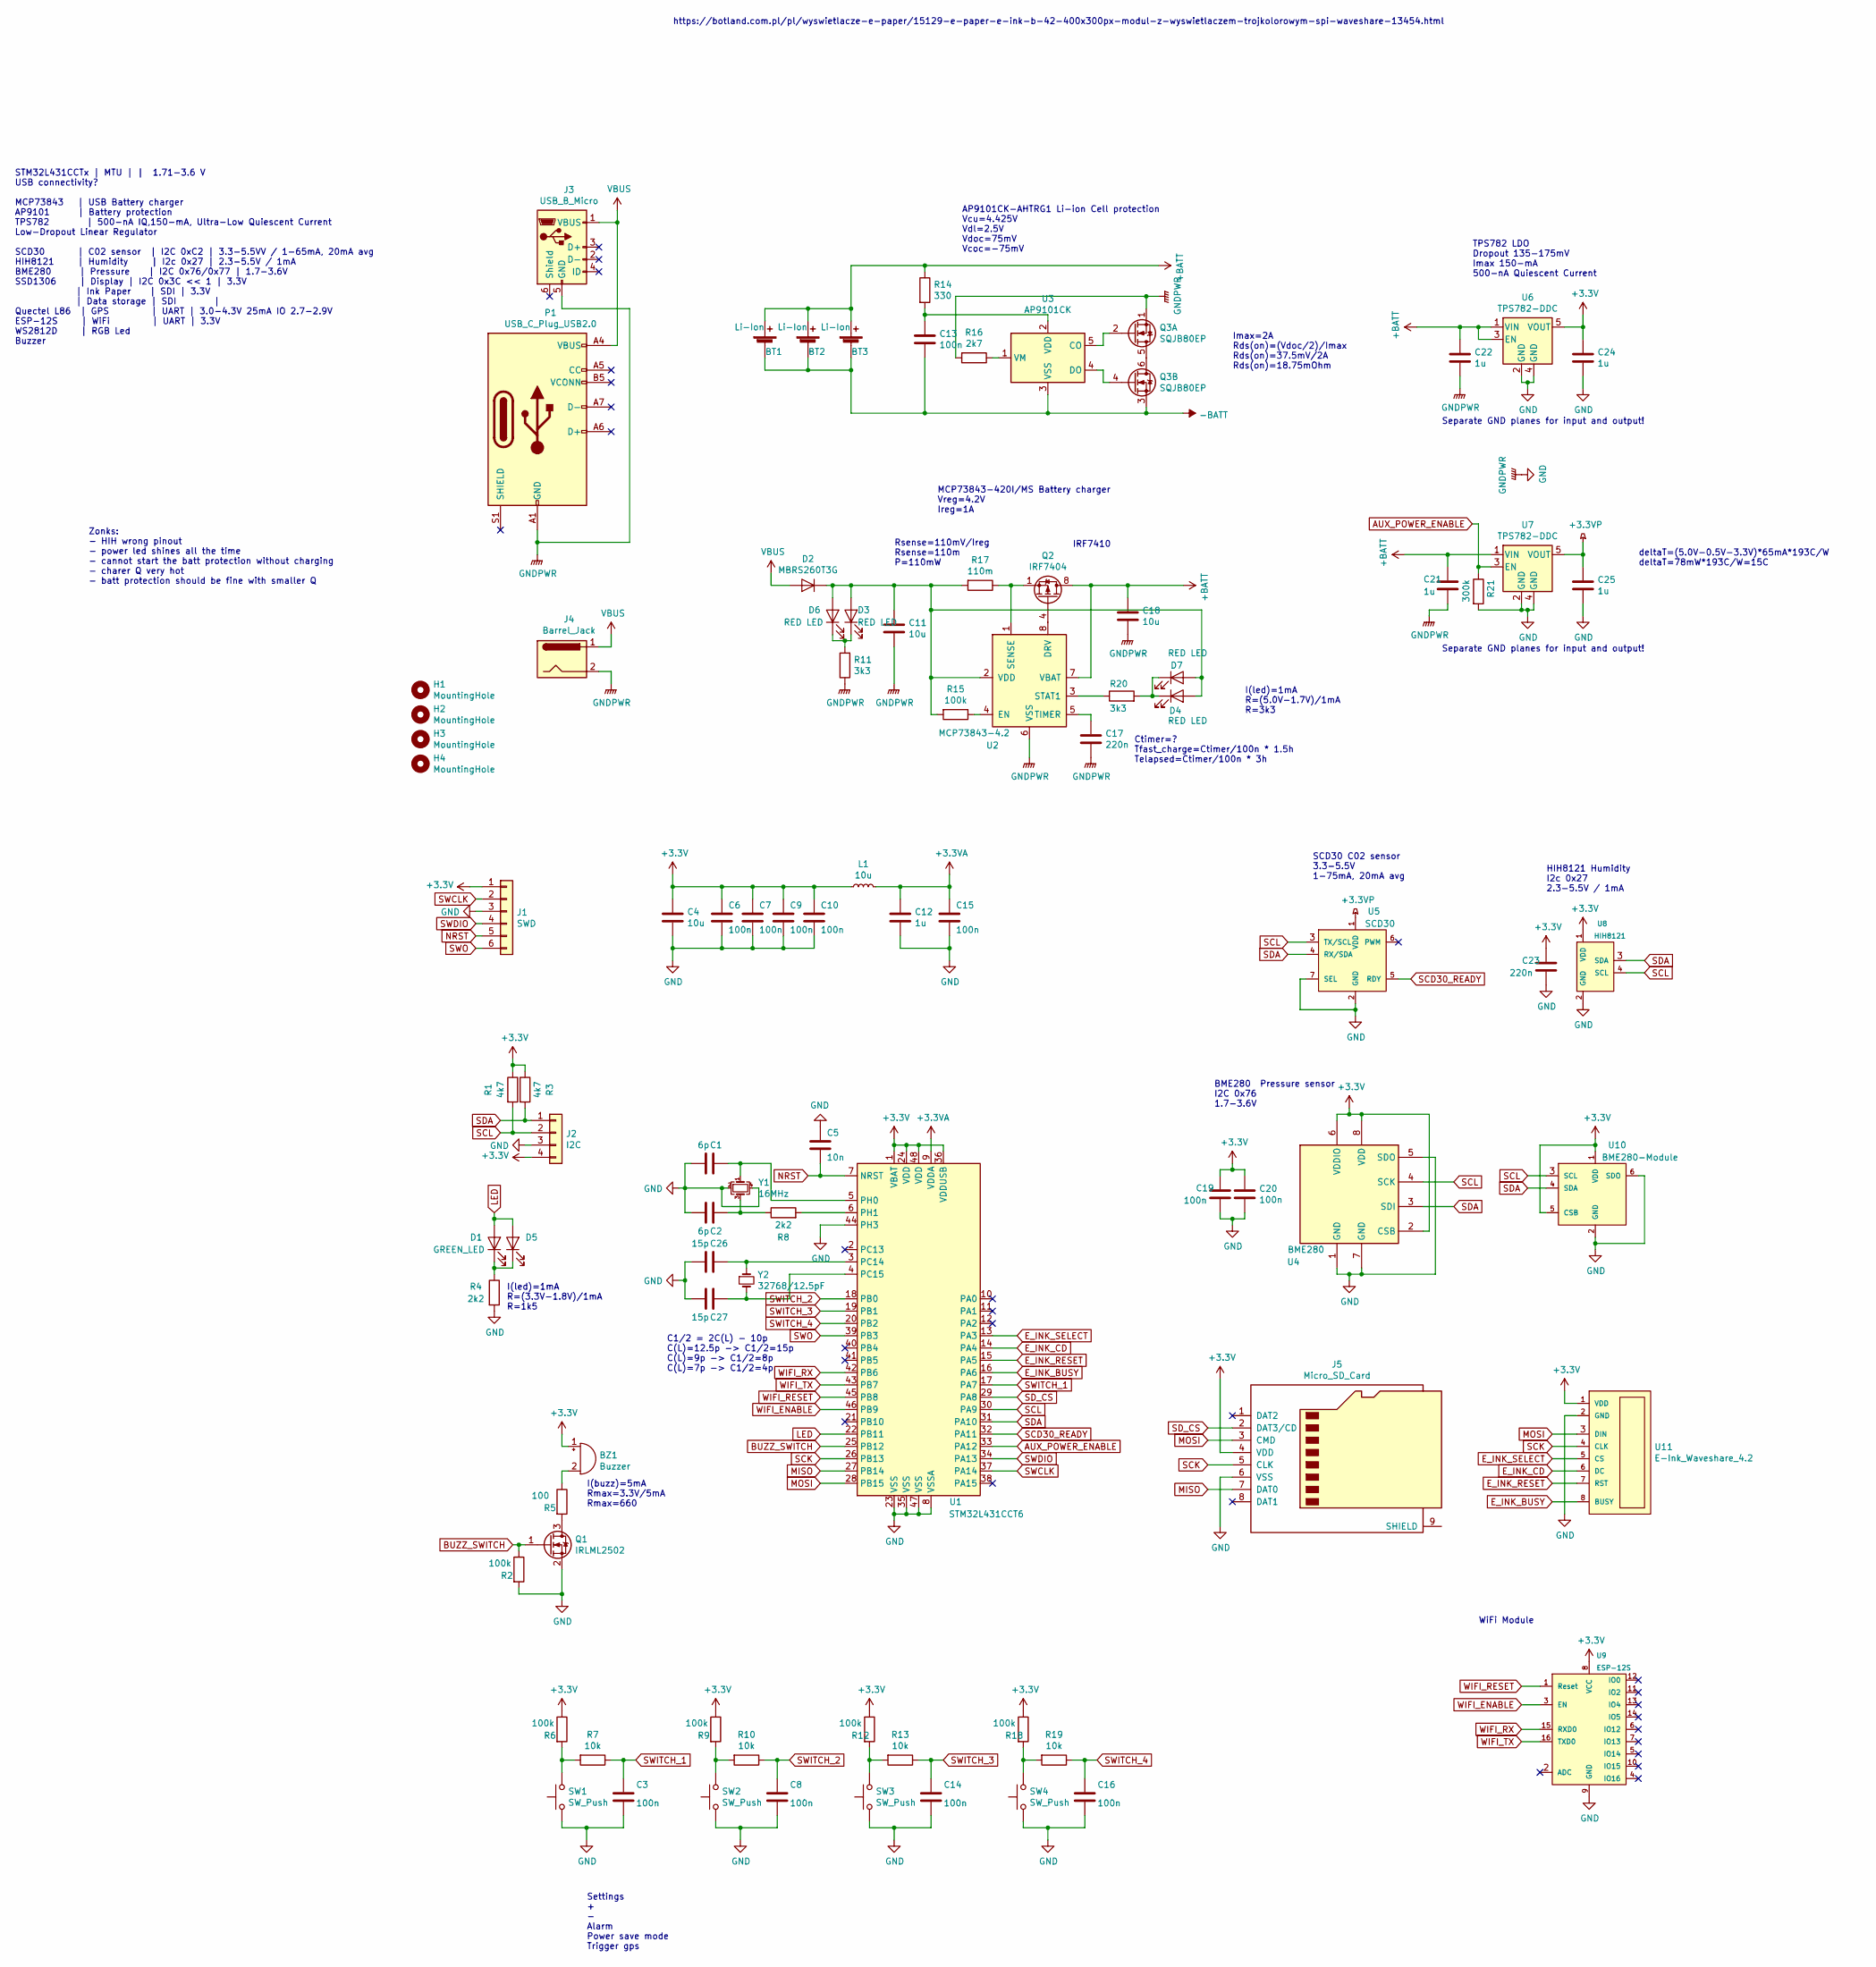
[picture p21: schematic EnvSensor.sch, Environmental Sensor]

Parts:
BT1, BT2, BT3: Li-Ion; BatteryHolder_Keystone_1042_1x18650
BZ1: Buzzer; Laudity_SPB45
C1, C2: 6p; C_0805_2012Metric
C3, C6, C7, C8, C9, C10, C13, C14, C15, C16, C19, C20: 100n; C_0603_1608Metric
C4, C11, C18: 10u; C_0805_2012Metric
C5: 10n; C_0805_2012Metric
C12, C21, C22, C24, C25: 1u; C_0805_2012Metric
C17, C23: 220n; C_0805_2012Metric
C26, C27: 15p; C_0805_2012Metric
D1: GREEN_LED; LED_0805_2012Metric
D2: MBRS260T3G; D_SMB
D3, D4: RED LED; LED_0805_2012Metric
D5: GREEN_LED; LED_D3.0mm
D6, D7: RED LED; LED_D3.0mm_Horizontal_O3.81mm_Z10.0mm
H1, H2, H3, H4: MountingHole; MountingHole_3.2mm_M3
J1: SWD; PinHeader_1x06_P2.54mm_Horizontal
J2: I2C; PinSocket_1x04_P2.54mm_Vertical
J3: USB_B_Micro; USB_Micro-B_Molex_47346-0001
J4: Barrel_Jack; PowerSocketSMD
J5: Micro_SD_Card; microSD_HC_Hirose_DM3AT-SF-PEJM5
L1: 10u; L_0805_2012Metric
P1: USB_C_Plug_USB2.0; USB_C_Receptacle_Adam_Tech
Q1: IRLML2502; SOT-23
Q2: IRF7404; SOIC-8_3.9x4.9mm_P1.27mm
Q3: SQJB80EP; PowerPAK_SO-8_Dual
R1, R3: 4k7; R_0805_2012Metric
R2, R6, R9, R12, R15, R18: 100k; R_0603_1608Metric
R4, R8: 2k2; R_0805_2012Metric
R5: 100; R_0805_2012Metric
R7, R10, R13, R19: 10k; R_0603_1608Metric
R11, R20: 3k3; R_0805_2012Metric
R14: 330; R_0805_2012Metric
R16: 2k7; R_0805_2012Metric
R17: 110m; R_2512_6332Metric
R21: 300k; R_0805_2012Metric
SW1, SW2, SW3, SW4: SW_Push; SW_SPST_PTS645
U1: STM32L431CCT6; LQFP-48_7x7mm_P0.5mm
U2: MCP73843-4.2; MSOP-8_3x3mm_P0.65mm
U3: AP9101CK; SOT-23-5
U4: BME280; Bosch_LGA-8_2.5x2.5mm_P0.65mm_ClockwisePinNumbering
U5: SCD30
U6, U7: TPS782-DDC; SOT-23-5
U8: HIH8121; PinHeader_1x04_P1.27mm_Vertical
U9: ESP-12S
U10: BME280-Module
U11: E-Ink_Waveshare_4.2; 4.2inch_E-Ink
Y1: 16MHz; Crystal_SMD_Abracon_ABM3B-4Pin_5.0x3.2mm
Y2: 32768/12.5pF; Crystal_SMD_MicroCrystal_CC7V-T1A-2Pin_3.2x1.5mm

Connections:
+3.3VA: C12.1, C15.1, L1.2, U1.9 (VDDA)
+3.3VP: C25.1, U5.1 (VDD), U7.5 (VOUT)
+3V3: BZ1.1 (-), C4.1, C6.1, C7.1, C9.1, C10.1, C19.1, C20.1, C23.1, C24.1, J1.1, J2.4, J5.4 (VDD), L1.1, R1.1, R3.1, R6.1, R9.1, R12.1, R18.1, U1.1 (VBAT), U1.24 (VDD), U1.36 (VDDUSB), U1.48 (VDD), U4.2 (CSB), U4.6 (VDDIO), U4.8 (VDD), U6.5 (VOUT), U8.1 (VDD), U9.8 (VCC), U10.1 (VDD), U10.5 (CSB), U11.1 (VDD)
+BATT: BT1.1 (+), BT2.1 (+), BT3.1 (+), C18.1, C21.1, C22.1, Q2.5 (D), Q2.6 (D), Q2.7 (D), Q2.8 (D), R14.1, U2.7 (VBAT), U6.1 (VIN), U6.3 (EN), U7.1 (VIN)
-BATT: BT1.2 (-), BT2.2 (-), BT3.2 (-), C13.2, Q3.3 (S2), U3.3 (VSS)
AUX_POWER_ENABLE: R21.1, U1.33 (PA12), U7.3 (EN)
BUZZ_SWITCH: Q1.1 (G), R2.1, U1.25 (PB12)
E_INK_BUSY: U1.16 (PA6), U11.8 (BUSY)
E_INK_CD: U1.14 (PA4), U11.6 (DC)
E_INK_RESET: U1.15 (PA5), U11.7 (RST)
E_INK_SELECT: U1.13 (PA3), U11.5 (CS)
GND: C1.2, C2.2, C3.2, C4.2, C5.1, C6.2, C7.2, C8.2, C9.2, C10.2, C11.2, C12.2, C14.2, C15.2, C16.2, C17.2, C18.2, C19.2, C20.2, C21.2, C22.2, C23.2, C24.2, C25.2, C26.2, C27.2, J1.3, J2.3, J3.5 (GND), J4.2, J5.6 (VSS), P1.A1 (GND), P1.A12 (GND), P1.B1 (GND), P1.B12 (GND), Q1.2 (S), Q3.1 (S2), R2.2, R4.2, R11.1, R16.2, R21.2, SW1.1, SW2.1, SW3.1, SW4.1, U1.8 (VSSA), U1.23 (VSS), U1.35 (VSS), U1.44 (PH3), U1.47 (VSS), U2.6 (VSS), U4.1 (GND), U4.5 (SDO), U4.7 (GND), U5.2 (GND), U5.7 (SEL), U6.2 (GND), U6.4 (GND), U7.2 (GND), U7.4 (GND), U8.2 (GND), U9.9 (GND), U10.2 (GND), U10.6 (SDO), U11.2 (GND), Y1.2, Y1.4
LED: D1.2 (A), D5.2 (A), U1.22 (PB11)
MISO: J5.7 (DAT0), U1.27 (PB14)
MOSI: J5.3 (CMD), U1.28 (PB15), U11.3 (DIN)
NRST: C5.2, J1.5, U1.7 (NRST)
unnamed: BZ1.2 (+), R5.1
unnamed: C1.1, U1.5 (PH0), Y1.1
unnamed: C2.1, R8.1, Y1.3
unnamed: C11.1, D2.1 (K), D3.2 (A), D4.2 (A), D6.2 (A), D7.2 (A), R15.2, R17.2, U2.2 (VDD)
unnamed: C13.1, R14.2, U3.2 (VDD)
unnamed: C17.1, U2.5 (TIMER)
unnamed: C26.1, U1.3 (PC14), Y2.1
unnamed: C27.1, U1.4 (PC15), Y2.2
unnamed: D1.1 (K), D5.1 (K), R4.1
unnamed: D3.1 (K), D6.1 (K), R11.2
unnamed: D4.1 (K), D7.1 (K), R20.2
unnamed: Q1.3 (D), R5.2
unnamed: Q2.1 (S), Q2.2 (S), Q2.3 (S), R17.1, U2.1 (SENSE)
unnamed: Q2.4 (G), U2.8 (DRV)
unnamed: Q3.2 (G2), U3.5 (CO)
unnamed: Q3.4 (G2), U3.4 (DO)
unnamed: Q3.5 (D2), Q3.6 (D2)
unnamed: R6.2, R7.2, SW1.2
unnamed: R8.2, U1.6 (PH1)
unnamed: R9.2, R10.2, SW2.2
unnamed: R12.2, R13.2, SW3.2
unnamed: R15.1, U2.4 (EN)
unnamed: R16.1, U3.1 (VM)
unnamed: R18.2, R19.2, SW4.2
unnamed: R20.1, U2.3 (STAT1)
SCD30_READY: U1.32 (PA11), U5.5 (RDY)
SCK: J5.5 (CLK), U1.26 (PB13), U11.4 (CLK)
SCL: J2.2, R1.2, U1.30 (PA9), U4.4 (SCK), U5.3 (TX/SCL), U8.4 (SCL), U10.3 (SCL)
SDA: J2.1, R3.2, U1.31 (PA10), U4.3 (SDI), U5.4 (RX/SDA), U8.3 (SDA), U10.4 (SDA)
SD_CS: J5.2 (DAT3/CD), U1.29 (PA8)
SWCLK: J1.2, U1.37 (PA14)
SWDIO: J1.4, U1.34 (PA13)
SWITCH_1: C3.1, R7.1, U1.17 (PA7)
SWITCH_2: C8.1, R10.1, U1.18 (PB0)
SWITCH_3: C14.1, R13.1, U1.19 (PB1)
SWITCH_4: C16.1, R19.1, U1.20 (PB2)
SWO: J1.6, U1.39 (PB3)
VBUS: D2.2 (A), J3.1 (VBUS), J4.1, P1.A4 (VBUS), P1.A9 (VBUS), P1.B4 (VBUS), P1.B9 (VBUS)
WIFI_ENABLE: U1.46 (PB9), U9.3 (EN)
WIFI_RESET: U1.45 (PB8), U9.1 (Reset)
WIFI_RX: U1.42 (PB6), U9.15 (RXD0)
WIFI_TX: U1.43 (PB7), U9.16 (TXD0)

Notes on the sheet:
STM32L431CCTx | MTU | | 1.71-3.6 V USB connectivity? MCP73843 | USB Battery charger AP9101 | Battery protection TPS782 | 500-nA IQ,150-mA, Ultra-Low Quiescent Current Low-Dropout Linear Regulator SCD30 | C02 sensor | I2C 0xC2 | 3.3-5.5VV / 1-65mA, 20mA avg HIH8121 | Humidity | I2c 0x27 | 2.3-5.5V /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
https://botland.com.pl/pl/wyswietlacze-e-paper/15129-e-paper-e-ink-b-42-400x300px-modul-z-wyswietlaczem-trojkolorowym-spi-waveshare-13454.html
TPS782 LDO Dropout 135-175mV Imax 150-mA 500-nA Quiescent Current
Separate GND planes for input and output!
MCP73843-420I/MS Battery charger Vreg=4.2V Ireg=1A
I(led)=1mA R=(5.0V-1.7V)/1mA R=3k3
Ctimer=? Tfast_charge=Ctimer/100n * 1.5h Telapsed=Ctimer/100n * 3h
Rsense=110mV/Ireg Rsense=110m P=110mW
IRF7410
AP9101CK-AHTRG1 Li-ion Cell protection Vcu=4.425V Vdl=2.5V Vdoc=75mV Vcoc=-75mV
SCD30 C02 sensor 3.3-5.5V 1-75mA, 20mA avg
HIH8121 Humidity I2c 0x27 2.3-5.5V / 1mA
Zonks: - HIH wrong pinout - power led shines all the time - cannot start the batt protection without charging - charer Q very hot - batt protection should be fine with smaller Q
BME280 Pressure sensor I2C 0x76 1.7-3.6V
I(led)=1mA R=(3.3V-1.8V)/1mA R=1k5
WiFi Module
Settings + - Alarm Power save mode Trigger gps
Imax=2A Rds(on)=(Vdoc/2)/Imax Rds(on)=37.5mV/2A Rds(on)=18.75mOhm
C1/2 = 2C(L) - 10p C(L)=12.5p -> C1/2=15p C(L)=9p -> C1/2=8p C(L)=7p -> C1/2=4p
I(buzz)=5mA Rmax=3.3V/5mA Rmax=660
deltaT=(5.0V-0.5V-3.3V)*65mA*193C/W deltaT=78mW*193C/W=15C

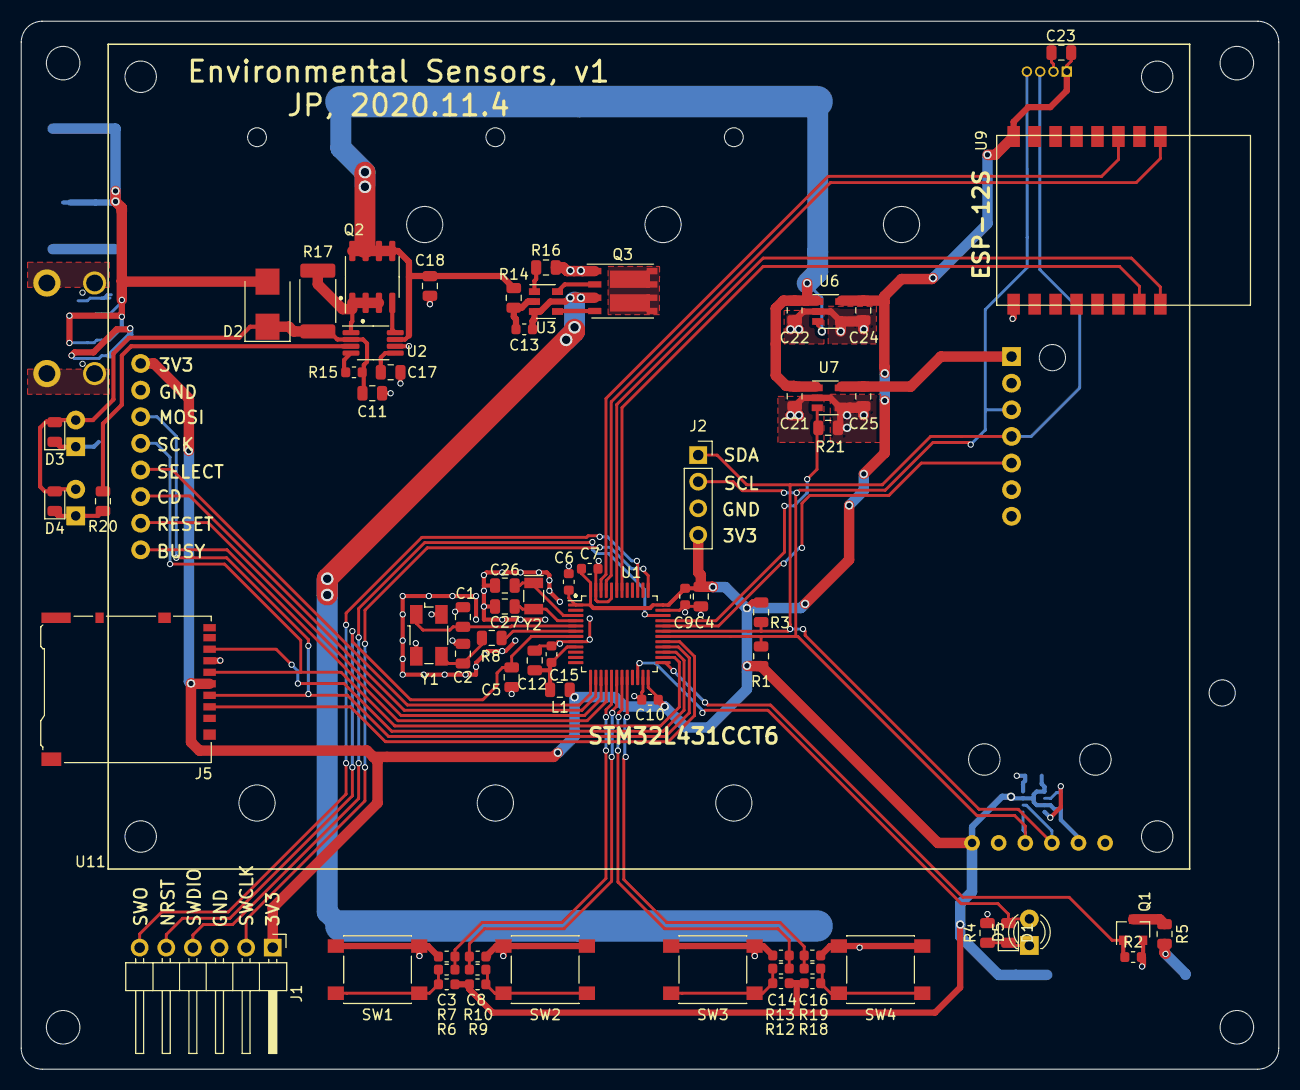
[picture p22: board EnvSensor.kicad_pcb from above]

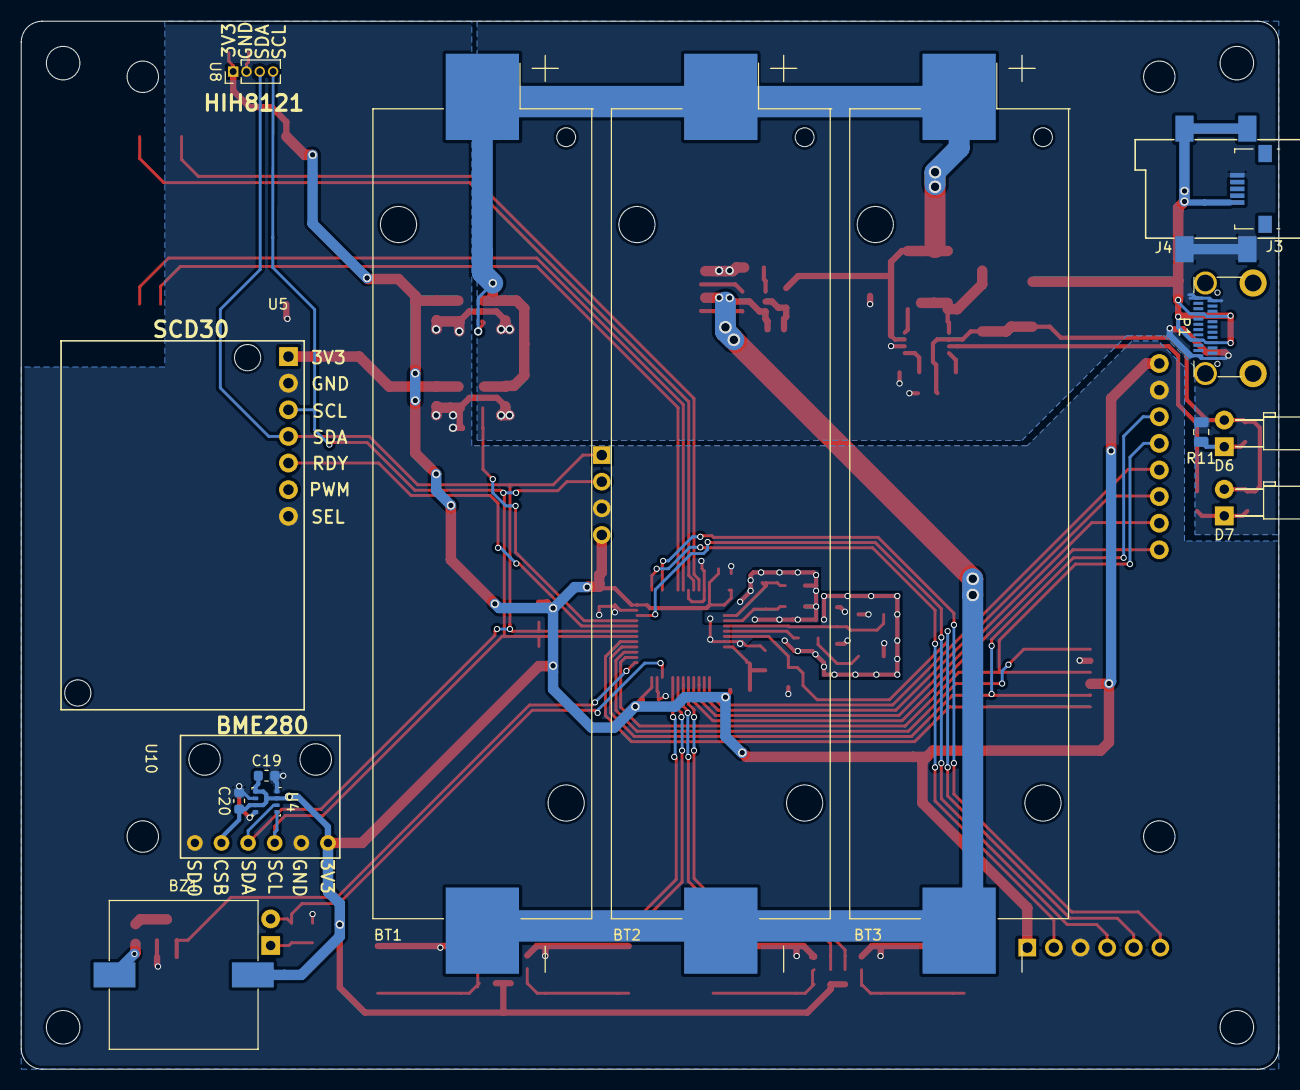
[picture p23: board EnvSensor.kicad_pcb from below]

Board: 2 copper layers, 120.0 x 100.0 mm, 90 parts (16 on the bottom side), 58 nets.
