jakubprzybytek/Environmental-Sensors/STM32CubeIDE/EnvSensorV2.1/Core/Src/main.c

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
/* Includes ------------------------------------------------------------------*/
#include "main.h"
#include "cmsis_os.h"
#include "fatfs.h"
#include "app_touchgfx.h"

/* USER CODE BEGIN Includes */
#include <EnvSensorV2_1.hpp>
#include <Readouts/Collector/SensorMessages.hpp>
#include <Display/DisplayCommandMessage.hpp>
/* USER CODE END Includes */

typedef StaticTask_t osStaticThreadDef_t;
typedef StaticSemaphore_t osStaticMutexDef_t;
ADC_HandleTypeDef hadc1;

CRC_HandleTypeDef hcrc;

I2C_HandleTypeDef hi2c1;

RTC_HandleTypeDef hrtc;

SD_HandleTypeDef hsd1;
DMA_HandleTypeDef hdma_sdmmc1_rx;

SPI_HandleTypeDef hspi1;

UART_HandleTypeDef huart2;

/* Definitions for defaultTask */
osThreadId_t defaultTaskHandle;
uint32_t defaultTaskBuffer[ 1024 ];
osStaticThreadDef_t defaultTaskControlBlock;
const osThreadAttr_t defaultTask_attributes = {
  .name = "defaultTask",
  .cb_mem = &defaultTaskControlBlock,
  .cb_size = sizeof(defaultTaskControlBlock),
  .stack_mem = &defaultTaskBuffer[0],
  .stack_size = sizeof(defaultTaskBuffer),
  .priority = (osPriority_t) osPriorityNormal,
};
/* Definitions for debugLogQueue */
osMessageQueueId_t debugLogQueueHandle;
const osMessageQueueAttr_t debugLogQueue_attributes = {
  .name = "debugLogQueue"
};
/* Definitions for sensorReadoutsQueue */
osMessageQueueId_t sensorReadoutsQueueHandle;
const osMessageQueueAttr_t sensorReadoutsQueue_attributes = {
  .name = "sensorReadoutsQueue"
};
/* Definitions for displayCommandsQueue */
osMessageQueueId_t displayCommandsQueueHandle;
const osMessageQueueAttr_t displayCommandsQueue_attributes = {
  .name = "displayCommandsQueue"
};
/* Definitions for i2c1Mutex */
osMutexId_t i2c1MutexHandle;
osStaticMutexDef_t i2c1MutexControlBlock;
const osMutexAttr_t i2c1Mutex_attributes = {
  .name = "i2c1Mutex",
  .cb_mem = &i2c1MutexControlBlock,
  .cb_size = sizeof(i2c1MutexControlBlock),
};
void SystemClock_Config(void);
static void MX_GPIO_Init(void);
static void MX_DMA_Init(void);
static void MX_I2C1_Init(void);
static void MX_ADC1_Init(void);
static void MX_CRC_Init(void);
static void MX_SPI1_Init(void);
static void MX_USART2_UART_Init(void);
static void MX_SDMMC1_SD_Init(void);
static void MX_RTC_Init(void);
void StartDefaultTask(void *argument);

/* USER CODE BEGIN PFP */
	//Create config functions for rx and tx dma
    static HAL_StatusTypeDef SD_DMAConfigRx(SD_HandleTypeDef *hsd);
    static HAL_StatusTypeDef SD_DMAConfigTx(SD_HandleTypeDef *hsd);
/* USER CODE END PFP */

/**
  * @brief  The application entry point.
  * @retval int
  */
int main(void)
{

  /* MCU Configuration--------------------------------------------------------*/

  /* Reset of all peripherals, Initializes the Flash interface and the Systick. */
  HAL_Init();

  /* Configure the system clock */
  SystemClock_Config();

  /* Initialize all configured peripherals */
  MX_GPIO_Init();
  MX_DMA_Init();
  MX_I2C1_Init();
  MX_ADC1_Init();
  MX_CRC_Init();
  MX_SPI1_Init();
  MX_USART2_UART_Init();
  MX_FATFS_Init();
  MX_SDMMC1_SD_Init();
  MX_RTC_Init();
  MX_TouchGFX_Init();
  /* Call PreOsInit function */
  MX_TouchGFX_PreOSInit();
  /* USER CODE BEGIN 2 */

  HAL_PWREx_EnableBatteryCharging(PWR_BATTERY_CHARGING_RESISTOR_1_5);

  /* USER CODE END 2 */

  /* Init scheduler */
  osKernelInitialize();
  /* Create the mutex(es) */
  /* creation of i2c1Mutex */
  i2c1MutexHandle = osMutexNew(&i2c1Mutex_attributes);

  /* USER CODE BEGIN RTOS_MUTEX */
  /* add mutexes, ... */
  /* USER CODE END RTOS_MUTEX */

  /* USER CODE BEGIN RTOS_SEMAPHORES */
  /* add semaphores, ... */
  /* USER CODE END RTOS_SEMAPHORES */

  /* USER CODE BEGIN RTOS_TIMERS */
  /* start timers, add new ones, ... */
  /* USER CODE END RTOS_TIMERS */

  /* Create the queue(s) */
  /* creation of debugLogQueue */
  debugLogQueueHandle = osMessageQueueNew (16, 30, &debugLogQueue_attributes);

  /* creation of sensorReadoutsQueue */
  sensorReadoutsQueueHandle = osMessageQueueNew (6, sizeof(ReadoutMessage_t), &sensorReadoutsQueue_attributes);

  /* creation of displayCommandsQueue */
  displayCommandsQueueHandle = osMessageQueueNew (6, sizeof(DisplayCommandMessage_t), &displayCommandsQueue_attributes);

  /* USER CODE BEGIN RTOS_QUEUES */
  /* add queues, ... */
  /* USER CODE END RTOS_QUEUES */

  /* Create the thread(s) */
  /* creation of defaultTask */
  defaultTaskHandle = osThreadNew(StartDefaultTask, NULL, &defaultTask_attributes);

  /* USER CODE BEGIN RTOS_THREADS */
  EnvSensorV2_1_Init();
  /* USER CODE END RTOS_THREADS */

  /* USER CODE BEGIN RTOS_EVENTS */
  /* add events, ... */
  /* USER CODE END RTOS_EVENTS */

  /* Start scheduler */
  osKernelStart();

  /* We should never get here as control is now taken by the scheduler */

  /* Infinite loop */
  /* USER CODE BEGIN WHILE */
  while (1)
  {
    /* USER CODE END WHILE */

    /* USER CODE BEGIN 3 */
  }
  /* USER CODE END 3 */
}

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
/* USER CODE BEGIN 4 */
/**
      * @brief Configure the DMA to receive data from the SD card
      * @retval
      *  HAL_ERROR or HAL_OK
      */
    static HAL_StatusTypeDef SD_DMAConfigRx(SD_HandleTypeDef *hsd)
    {
      static DMA_HandleTypeDef hdma_rx;
      HAL_StatusTypeDef status = HAL_ERROR;

      /* Configure DMA Rx parameters */
      hdma_rx.Init.Request             = DMA_REQUEST_7;
      hdma_rx.Init.Direction           = DMA_PERIPH_TO_MEMORY;
      hdma_rx.Init.PeriphInc           = DMA_PINC_DISABLE;
      hdma_rx.Init.MemInc              = DMA_MINC_ENABLE;
      hdma_rx.Init.PeriphDataAlignment = DMA_PDATAALIGN_WORD;
      hdma_rx.Init.MemDataAlignment    = DMA_MDATAALIGN_WORD;
      hdma_rx.Init.Priority            = DMA_PRIORITY_VERY_HIGH;

      hdma_rx.Instance = DMA2_Channel4;

      /* Associate the DMA handle */
      __HAL_LINKDMA(hsd, hdmarx, hdma_rx);

      /* Stop any ongoing transfer and reset the state*/
      HAL_DMA_Abort(&hdma_rx);

      /* Deinitialize the Channel for new transfer */
      HAL_DMA_DeInit(&hdma_rx);

      /* Configure the DMA Channel */
      status = HAL_DMA_Init(&hdma_rx);

      /* NVIC configuration for DMA transfer complete interrupt */
      HAL_NVIC_SetPriority(DMA2_Channel4_IRQn, 6, 0);
      HAL_NVIC_EnableIRQ(DMA2_Channel4_IRQn);

      return (status);
    }

    /**
      * @brief Configure the DMA to transmit data to the SD card
      * @retval
      *  HAL_ERROR or HAL_OK
      */
    static HAL_StatusTypeDef SD_DMAConfigTx(SD_HandleTypeDef *hsd)
    {
      static DMA_HandleTypeDef hdma_tx;
      HAL_StatusTypeDef status;

      /* Configure DMA Tx parameters */
      hdma_tx.Init.Request             = DMA_REQUEST_7;
      hdma_tx.Init.Direction           = DMA_MEMORY_TO_PERIPH;
      hdma_tx.Init.PeriphInc           = DMA_PINC_DISABLE;
      hdma_tx.Init.MemInc              = DMA_MINC_ENABLE;
      hdma_tx.Init.PeriphDataAlignment = DMA_PDATAALIGN_WORD;
      hdma_tx.Init.MemDataAlignment    = DMA_MDATAALIGN_WORD;
      hdma_tx.Init.Priority            = DMA_PRIORITY_VERY_HIGH;

      hdma_tx.Instance = DMA2_Channel4;

      /* Associate the DMA handle */
      __HAL_LINKDMA(hsd, hdmatx, hdma_tx);

      /* Stop any ongoing transfer and reset the state*/
      HAL_DMA_Abort(&hdma_tx);

      /* Deinitialize the Channel for new transfer */
      HAL_DMA_DeInit(&hdma_tx);

      /* Configure the DMA Channel */
      status = HAL_DMA_Init(&hdma_tx);

      /* NVIC configuration for DMA transfer complete interrupt */
      HAL_NVIC_SetPriority(DMA2_Channel4_IRQn, 6, 0);
      HAL_NVIC_EnableIRQ(DMA2_Channel4_IRQn);

      return (status);
    }

    //Override DMA write functions
    uint8_t BSP_SD_WriteBlocks_DMA(uint32_t *pData, uint32_t WriteAddr, uint32_t NumOfBlocks)
    {
      uint8_t sd_state = MSD_OK;

      // Invalidate the dma rx handle
      hsd1.hdmarx = NULL;

      // Prepare the dma channel for a read operation
      sd_state = SD_DMAConfigTx(&hsd1);

      if(sd_state == HAL_OK)
      {
        /* Write block(s) in DMA transfer mode */
        sd_state = HAL_SD_WriteBlocks_DMA(&hsd1, (uint8_t *)pData, WriteAddr, NumOfBlocks);
      }

      if( sd_state == HAL_OK)
      {
        return MSD_OK;
      }
      else
      {
        return MSD_ERROR;
      }

      return sd_state;
    }

    //Override DMA read functions
    uint8_t BSP_SD_ReadBlocks_DMA(uint32_t *pData, uint32_t ReadAddr, uint32_t NumOfBlocks)
    {
      uint8_t sd_state = MSD_OK;
      /* Invalidate the dma tx handle*/
      hsd1.hdmatx = NULL;

      /* Prepare the dma channel for a read operation */
      sd_state = SD_DMAConfigRx(&hsd1);

      if(sd_state == HAL_OK)
      {
           /* Read block(s) in DMA transfer mode */
            sd_state = HAL_SD_ReadBlocks_DMA(&hsd1, (uint8_t *)pData, ReadAddr, NumOfBlocks);
      }

      if( sd_state == HAL_OK)
      {
        return MSD_OK;
      }
      else
      {
        return MSD_ERROR;
      }
    }


/* USER CODE END 4 */

/* USER CODE BEGIN Header_StartDefaultTask */
/**
  * @brief  Function implementing the defaultTask thread.
  * @param  argument: Not used
  * @retval None
  */
/* USER CODE END Header_StartDefaultTask */
void StartDefaultTask(void *argument)
{
  /* USER CODE BEGIN 5 */
	MX_TouchGFX_Process();
  /* Infinite loop */
  for(;;)
  {
    osDelay(1);
  }
  /* USER CODE END 5 */
}

/**
  * @brief  Period elapsed callback in non blocking mode
  * @note   This function is called  when TIM6 interrupt took place, inside
  * HAL_TIM_IRQHandler(). It makes a direct call to HAL_IncTick() to increment
  * a global variable "uwTick" used as application time base.
  * @param  htim : TIM handle
  * @retval None
  */
void HAL_TIM_PeriodElapsedCallback(TIM_HandleTypeDef *htim)
{
  if (htim->Instance == TIM6) {
    HAL_IncTick();
  }
}

/**
  * @brief  This function is executed in case of error occurrence.
  * @retval None
  */
void Error_Handler(void)
{
  /* USER CODE BEGIN Error_Handler_Debug */
  /* User can add his own implementation to report the HAL error return state */
  __disable_irq();
  while (1)
  {
  }
  /* USER CODE END Error_Handler_Debug */
}

#ifdef  USE_FULL_ASSERT
/**
  * @brief  Reports the name of the source file and the source line number
  *         where the assert_param error has occurred.
  * @param  file: pointer to the source file name
  * @param  line: assert_param error line source number
  * @retval None
  */
void assert_failed(uint8_t *file, uint32_t line)
{
  /* USER CODE BEGIN 6 */
  /* User can add his own implementation to report the file name and line number,
     ex: printf("Wrong parameters value: file %s on line %d\r\n", file, line) */
  /* USER CODE END 6 */
}
#endif /* USE_FULL_ASSERT */
