jakubprzybytek/Environmental-Sensors/STM32CubeIDE/EnvSensorV2.1/EnvSensorV2.1.ioc

Mcu.UserName=STM32L451RETx
PA0.GPIO_Label=BATTERY_MEASURE_INPUT
PA0.Signal=ADCx_IN5
PA10.Signal=I2C1_SDA
PA11.GPIO_Label=SDIO_POWER_ENABLE
PA11.Signal=GPIO_Output
PA12.GPIO_Label=SDIO_DETECT
PA12.Signal=GPIO_Input
PA2.Signal=USART2_TX
PA3.Signal=USART2_RX
PA5.Signal=SPI1_SCK
PA7.Signal=SPI1_MOSI
PA8.GPIO_Label=SCD30_READY
PA8.Signal=GPXTI8
PA9.Signal=I2C1_SCL
PB0.GPIO_Label=E_INK_RESET
PB0.Signal=GPIO_Output
PB1.GPIO_Label=E_INK_BUSY
PB1.Signal=GPXTI1
PB12.GPIO_Label=SWITCH_1
PB12.Signal=GPXTI12
PB13.GPIO_Label=SWITCH_2
PB13.Signal=GPXTI13
PB14.GPIO_Label=SWITCH_3
PB14.Signal=GPXTI14
PB15.GPIO_Label=SWITCH_4
PB15.Signal=GPXTI15
PB2.GPIO_Label=POWER_5V_ENABLE
PB2.Signal=GPIO_Output
PC0.GPIO_Label=LED_4
PC0.Signal=GPIO_Output
PC1.GPIO_Label=LED_3
PC1.Signal=GPIO_Output
PC10.Signal=SDMMC1_D2
PC11.Signal=SDMMC1_D3
PC12.Signal=SDMMC1_CK
PC2.GPIO_Label=LED_2
PC2.Signal=GPIO_Output
PC3.GPIO_Label=LED_1
PC3.Signal=GPIO_Output
PC4.GPIO_Label=E_INK_SELECT
PC4.Signal=GPIO_Output
PC5.GPIO_Label=E_INK_DC
PC5.Signal=GPIO_Output
PC6.GPIO_Label=BATTERY_MEASURE_ENABLE
PC6.Signal=GPIO_Output
PC8.Signal=SDMMC1_D0
PC9.Signal=SDMMC1_D1
PD2.Signal=SDMMC1_CMD
