jakubprzybytek/Environmental-Sensors/STM32CubeIDE/EnvSensorV2.1/User/Inc/Display/Leds.hpp

/*
 * Leds.hpp
 *
 *  Created on: 2 Apr 2023
 *      Author: jakub.przybytek
 */

#ifndef INC_LEDS_HPP_
#define INC_LEDS_HPP_

#include <main.h>

#define CPU_LED_Port LED_1_GPIO_Port
#define CPU_LED_Pin LED_1_Pin
#define CPU_LED_On() HAL_GPIO_WritePin(CPU_LED_Port, CPU_LED_Pin, GPIO_PIN_SET)
#define CPU_LED_Off() HAL_GPIO_WritePin(CPU_LED_Port, CPU_LED_Pin, GPIO_PIN_RESET)

#define DISPLAY_LED_Port LED_2_GPIO_Port
#define DISPLAY_LED_Pin LED_2_Pin
#define DISPLAY_LED_On() HAL_GPIO_WritePin(DISPLAY_LED_Port, DISPLAY_LED_Pin, GPIO_PIN_SET)
#define DISPLAY_LED_Off() HAL_GPIO_WritePin(DISPLAY_LED_Port, DISPLAY_LED_Pin, GPIO_PIN_RESET)

#define SD_CARD_LED_Port LED_2_GPIO_Port
#define SD_CARD_LED_Pin LED_2_Pin
#define SD_CARD_LED_On() HAL_GPIO_WritePin(DISPLAY_LED_Port, DISPLAY_LED_Pin, GPIO_PIN_SET)
#define SD_CARD_LED_Off() HAL_GPIO_WritePin(DISPLAY_LED_Port, DISPLAY_LED_Pin, GPIO_PIN_RESET)

#define PARTICLES_SENSOR_LED_Port LED_3_GPIO_Port
#define PARTICLES_SENSOR_LED_Pin LED_3_Pin
#define PARTICLES_SENSOR_LED_On() HAL_GPIO_WritePin(PARTICLES_SENSOR_LED_Port, PARTICLES_SENSOR_LED_Pin, GPIO_PIN_SET)
#define PARTICLES_SENSOR_LED_Off() HAL_GPIO_WritePin(PARTICLES_SENSOR_LED_Port, PARTICLES_SENSOR_LED_Pin, GPIO_PIN_RESET)

#endif /* INC_LEDS_HPP_ */
