jakubprzybytek/Environmental-Sensors/(commit log)

2020-10-09 Schematic done
    [EnvSensor.sch]
2020-10-30 Some commit
    [EnvSensor.kicad_pcb, EnvSensor.sch]
2020-11-04 Last pcb fixes
    [EnvSensor.kicad_pcb, EnvSensor.sch]
2020-12-22 eInk initial code
    [EnvSensor Debug.cfg]
2020-12-22 TouchGFX and BMP280 code added
    [texts.xlsx]
2020-12-23 Screen improvements
    [texts.xlsx]
2020-12-23 Screen refactoring
    [texts.xlsx]
2020-12-23 Speaker added. Tweaks in screen
    [texts.xlsx]
2020-12-23 Faster eInk display transfer, faster I2C
    [EnvSensor.kicad_pcb]
2020-12-27 SCD30 code added
    [EnvSensor Debug.cfg, EnvSensor.sch, texts.xlsx]
2020-12-29 scd work
    [texts.xlsx]
2021-01-01 Single buffer fix. Retry code'
    [EnvSensor.kicad_pcb]
2021-01-04 Font sizes tweaks. Clean is now faster
    [texts.xlsx]
2021-01-07 Vdd readout routine added
    [texts.xlsx]
2021-01-10 Switched to 4.2 A module
2021-01-10 4.2 eInk switched to gray2 mode
    [texts.xlsx]
2021-01-15 Displaying sd available space
    [texts.xlsx]
2021-01-15 Displaying info about sd errors
    [texts.xlsx]
2021-01-19 Screen controllers introduced
    [texts.xlsx]
2021-01-19 Screen refactored
    [texts.xlsx]
2021-01-20 Displaying date and time
    [texts.xlsx]
2021-01-26 Charts view introduced
    [texts.xlsx]
2021-01-26 Memory leak bug fixed
    [Epd_4in2a.cpp]
2021-02-05 More on chart
    [texts.xlsx]
2021-02-08 Logger is now disabled on start up
    [texts.xlsx]
2021-02-08 Led blinking changed
2021-03-12 3d prints. Main screen amended. Last bar issue fixed
    [Buttons Membrane v1.stl, Case Bottom v2.stl, Case Top v2.stl, Environmental Sensor Case v6.f3d, texts.xlsx]
2021-09-05 last fixes
    [EnvSensor.sch]
2021-09-30 New PCB
    [EnvSensor-v2.kicad_pcb, EnvSensor-v2.sch]
2021-10-04 Work on pcb v2
    [EnvSensor-v2.kicad_pcb, EnvSensor-v2.sch, EnvSensor.sch]
2021-10-30 Finishing touches
    [EnvSensor-v2.kicad_pcb, EnvSensor-v2.sch, EnvSensor.sch]
2021-11-17 pcb finishing touches
    [EnvSensor-v2-B_Cu.gbr, EnvSensor-v2-B_Mask.gbr, EnvSensor-v2-B_SilkS.gbr, EnvSensor-v2-Edge_Cuts.gbr, EnvSensor-v2-F_Cu.gbr, EnvSensor-v2-F_Mask.gbr, EnvSensor-v2-F_SilkS.gbr, EnvSensor-v2-NPTH.drl]
2021-12-06 Optimising ground pane
    [EnvSensor-v2.kicad_pcb]
2022-01-24 STM32CubeIDE/EnvSensorV2 introduced
    [EnvSensor-v2.kicad_pcb, EnvSensor-v2.sch]
2022-01-26 sensors work
2022-01-29 Pressure, temp, humidity code clean up
2022-01-30 Particles sensor
2022-02-08 SDMMC and SPI enabled
2022-02-08 pcb updates
    [EnvSensor-v2.kicad_pcb, EnvSensor-v2.sch]
2022-02-26 touchgfx introduced
    [EnvSensor-v2.kicad_pcb, EnvSensor-v2.sch]
2022-02-27 temp and pressure
2022-06-11 Blinking leds extracted
2022-11-13 CO2 sensor refactoring
2022-11-13 Retries added to co2 sensor
2022-11-14 VoltageSensor introduced
2022-11-15 VoltageSensor. DisplayController
2022-11-17 Static thread allocation
2022-11-17 Voltage readout in state
2022-11-17 TouchGFX upgrade to 4.20.0 and Voltage Container
2022-11-17 TouchGFX upgrade in STM32CubeIDE
2022-11-17 Simple timer
2022-11-17 Default thread stack optimised
2022-11-19 Flushing frame buffer through Display Controller
2022-11-28 Initial 2.1 commit
    [EnvSensor-v2.1.kicad_pcb, EnvSensor-v2.1.kicad_sch]
2022-12-03 poznan commit
    [EnvSensor-v2.1.kicad_sch]
2022-12-14 pcb started
    [EnvSensor-v2.1.kicad_pcb, EnvSensor-v2.1.kicad_sch, EnvSensor-v2.kicad_sch]
2022-12-20 More pcb work
    [EnvSensor-v2.1.kicad_pcb, EnvSensor-v2.1.kicad_sch]
2022-12-28 more work
    [EnvSensor-v2.1.kicad_pcb]
2023-04-02 Upgrade to STM32CubeIDE 1.12
    [EnvSensor-v2.1.kicad_pcb, EnvSensor-v2.1.kicad_sch]
2023-04-02 CPU led and Display led introduced
2023-04-08 Final PCB work
    [EnvSensor-v2.1.kicad_pcb, EnvSensor-v2.1.kicad_sch]
2023-04-08 Main pcb
    [EnvSensor-Main-v2.1.kicad_pcb, EnvSensor-Main-v2.1.kicad_sch, EnvSensor-v2.1.kicad_pcb, EnvSensor-v2.1.kicad_sch]
2023-04-12 Main PCB work
    [EnvSensor-Main-v2.1.kicad_pcb, EnvSensor-Main-v2.1.kicad_sch, EnvSensor-v2.1.kicad_pcb]
2023-04-22 Main work done on PCB
    [EnvSensor-Main-v2.1.kicad_pcb, EnvSensor-Main-v2.1.kicad_sch]
2023-04-23 DateTime HardFault issue worked around
    [DateTime.cpp, RtcUtils.cpp]
2023-05-01 PCB work
    [EnvSensor-Main-v2.1.kicad_pcb]
2023-05-05 Particles sensor refactor
    [EnvSensor-Main-v2.1.kicad_sch]
2023-05-06 hpma pinout
    [EnvSensor-Main-v2.1.kicad_sch]
2023-05-06 STM32CubeIDE upgrade
2023-05-14 Power 5V management moved from HPA device to ParticlesSensor class
2023-05-15 Button label added
2023-05-20 New label in gui. Refactor of synchronisation code in particles sensor
2023-05-20 Paticles sensor - timings adjusted
2023-06-04 Temp I2C sync disabled
2023-06-04 Timer renamed to SensorsController
2023-06-04 Moving sensors initialization into SensorsController
2023-06-04 RCT enabled, co2 semaphor replaced with flag
    [CO2Sensor.cpp, main.c]
2023-06-09 Synchronising on display using interrupt
2023-06-16 SOme fixes
    [EnvSensor-Main-v2.1.kicad_sch]
2023-06-19 Failing Stop Auto Send command doesn't stop sensor now
    [DebugLog.cpp, Hpma115C0.cpp, ParticlesSensor.cpp]
2023-08-31 Missing assignements fixed
    [EnvSensor-Main-v2.1.kicad_sch]
2023-09-06 Finishing touhches on main board
    [EnvSensor-Main-v2.1.kicad_pcb, EnvSensor-Main-v2.1.kicad_sch]
2024-02-03 LM2735 fixes
    [EnvSensor-Main-v2.1.kicad_sch, EnvSensor-Power-v2.1.kicad_pcb, EnvSensor-Power-v2.1.kicad_sch]
2024-03-03 More fixes
    [EnvSensor-Main-v2.1.kicad_pcb, EnvSensor-Main-v2.1.kicad_sch, EnvSensor-Power-v2.1.kicad_pcb, EnvSensor-Power-v2.1.kicad_sch]
2024-06-16 Bore moving swd and i2c
    [EnvSensor-Main-v2.1.kicad_pcb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]
2024-06-23 Before moving i2c tracks
    [EnvSensor-Main-v2.1.kicad_pcb, EnvSensor-Main-v2.1.kicad_sch]
2024-09-21 c++ project for 2.1 introduced
    [Body1.stl, EnvSensor-Main-v2.1.kicad_pcb, EnvSensor-Power-v2.1.kicad_pcb, EnvSensor-Power-v2.1.kicad_sch]
2024-09-21 Small screen introduced
    [EnvSensor-Power-v2.1.kicad_pcb]
2024-10-14 sd card using SPI
2024-10-26 Bottom Buttons
2024-11-09 Buttons and leds
2024-11-21 Scalled y axis
2024-12-12 Particles Sensor tweaks
    [EnvSensor-Power-v2.1.kicad_pcb]
2024-12-14 CO2 sensor tweaks
2025-01-19 Delayed refresh refactored.
    [EnvSensor-Main-v2.1.kicad_sch, EnvSensor-Power-v2.1.kicad_sch]
2025-01-24 Sensors can be stopped and resumed
2025-01-26 Batt indicators. Empty battery screen.
