jakubprzybytek/Environmental-Sensors/(notices)

Notices in the files:
STM32CubeIDE/EnvSensorV2.1/Core/Inc/main.h:
Copyright (c) 2024 STMicroelectronics.
All rights reserved.
This software is licensed under terms that can be found in the LICENSE file
3dPrints/SFSD-05-28-H-05.00-SR.stp:
author */ ('License CC BY-ND 4.0'),
